ShrinathN/SimpleSpotWelder/README.md

# SimpleSpotWelder
I wanted a spot welder for 18650s so I designed this but then I didn't want a spot welder anymore so I never built it

This welder is designed to do
* Max 55J (more realistically 40J) solders
* Aprox 1000A for 100ms
