ShrinathN/SimpleSpotWelder/SimpleSpotWelderDesignLog.html

Simple Spot Welder Design Log

15 April 2025 - 1735 hours 2

FET Choice 2

17 April 2025 - 0000 hours 7

17 April 2025 - 2215 hours 7

18 April 2025 - 0152 hours 7

18 April 2025 - 1423 hours 8

19 April 2025 - 0413 hours 9

21 April 2025 - 1532 hours 10

3 May 2025 - 1550 hours 10

4 May 2025 - 0356 hours 10

# 15 April 2025 - 1735 hours

## FET Choice

Now is a good time to start the log. Not only to keep me focused but also so that I can itch my writing urge. Well let's get to into the meat then

I am debating if I should use IRF3205 (110A 50V 8mΩ NFETs) versus generic 50N03 (30A 50V 6.5mΩ FETs)

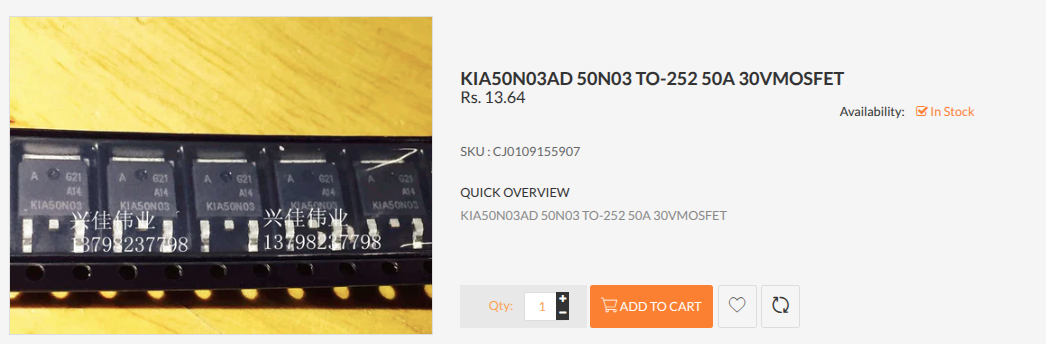
[picture p1: images/image10.png]


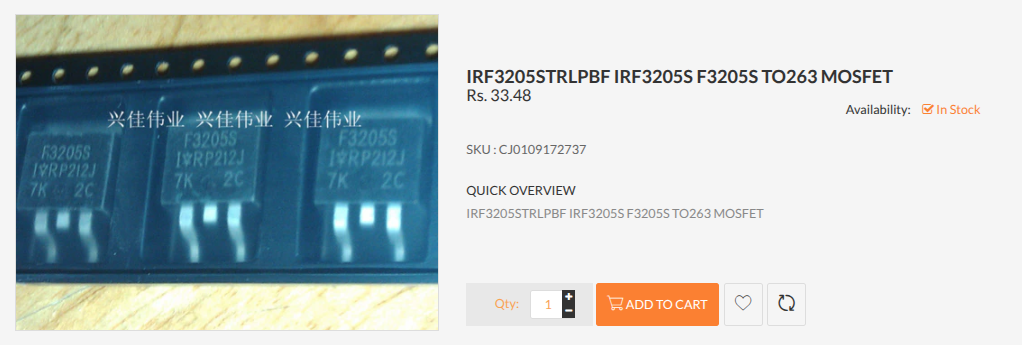
[picture p2: images/image4.png]


Ah the package of IRF3205 is TO-263 versus TO-252 for 50N03. Even though the price is more than double as much, IRF3205 seems like the better option because of the much larger footprint.

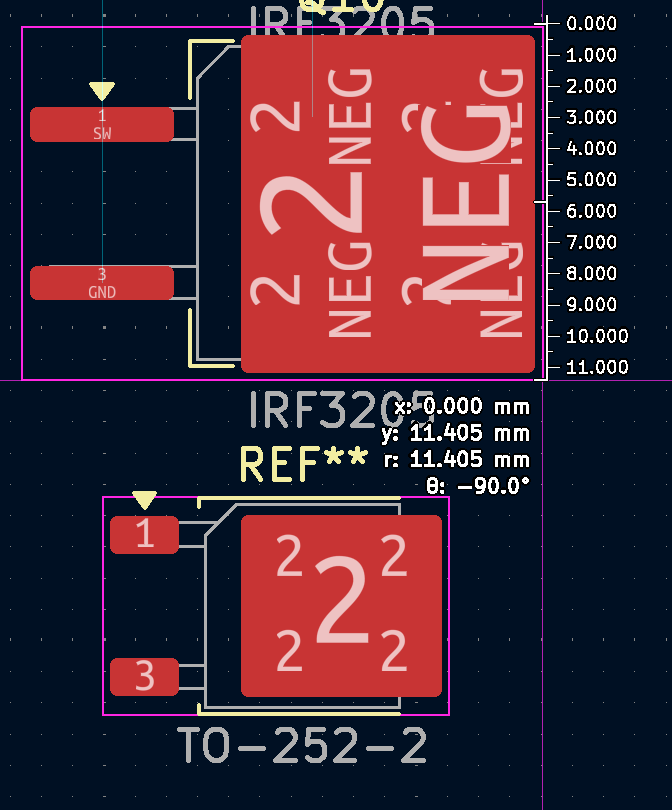
[picture p3: images/image6.png]


I choose IRF3205.

Tangent, writing this log has revealed to me that I may have been turning into an NPC, unable to focus on stuff and without an inner voice. I blame social media and distractions. Back to topic at hand.

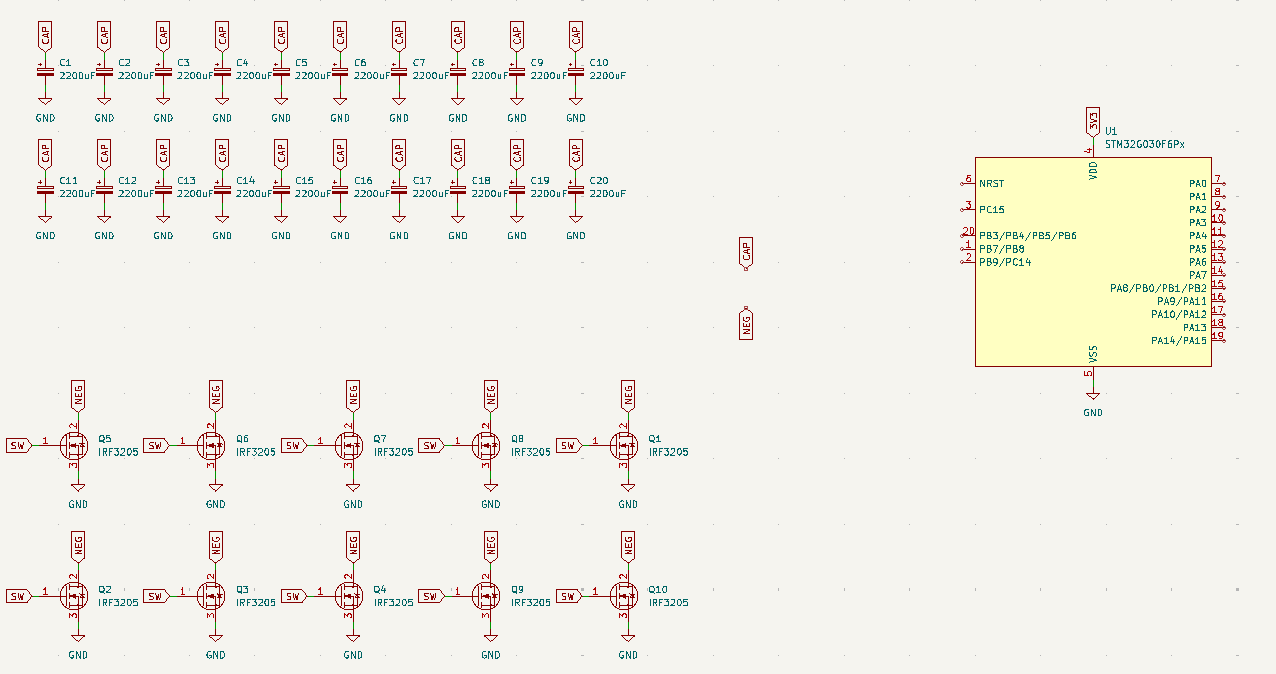
[picture p4: images/image2.png]
So this is how the schematics look right now. 

For making a decent spot welder, I need to have a decent pulse control. This means I should be able to turn on and off the MOSFETs very quickly, so that the linear region is as short as possible. This will also protect the MOSFETs.

The FETs have an Rds of 8mΩ, which 10 in parallel would mean 800uΩ.

At the normal 12V of the battery, it would equal to about 15000A of current. (V=IR)

Talking in charge, a 20x 2200uF capacitor bank, charged to 12V would have a total charge of 528mC (Q=CV).

Now if we take the charge, and the current, we get a discharge time of 35.2us (I=Q/t).

This means the entire capacitor bank would discharge in 35us if given a resistance of 800uΩ. Although this is just the theoretical max current, since the lead+trace+capacitor bank ESR resistance would dominate the calculation. I think I will have to assume a number for all of them because I cannot just assume it all to be 0.

The capacitor bank is 20x 2200uF 63V. So the total energy in the bank would be 55J, if charged to 50V. Since our FETs are 55V, it's better to limit charging to 45V, which would give us 44.45J. Now le

I am worried if the FETs will be able to tolerate the current peak.

I just found slightly better MOSFETs for the same price, but a lower voltage rating

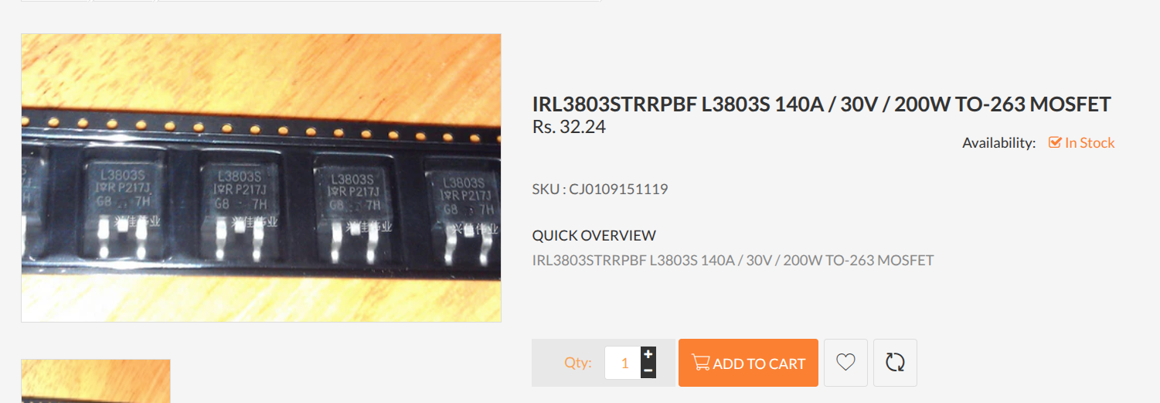
[picture p5: images/image5.png]


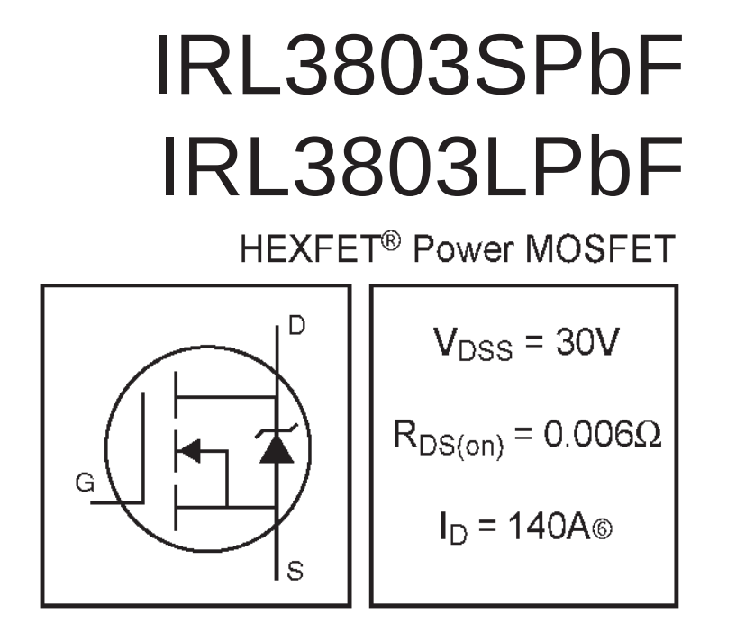
[picture p6: images/image11.png]


Rds is lower by 2mΩ. Not a large difference, but it will add up for sure.

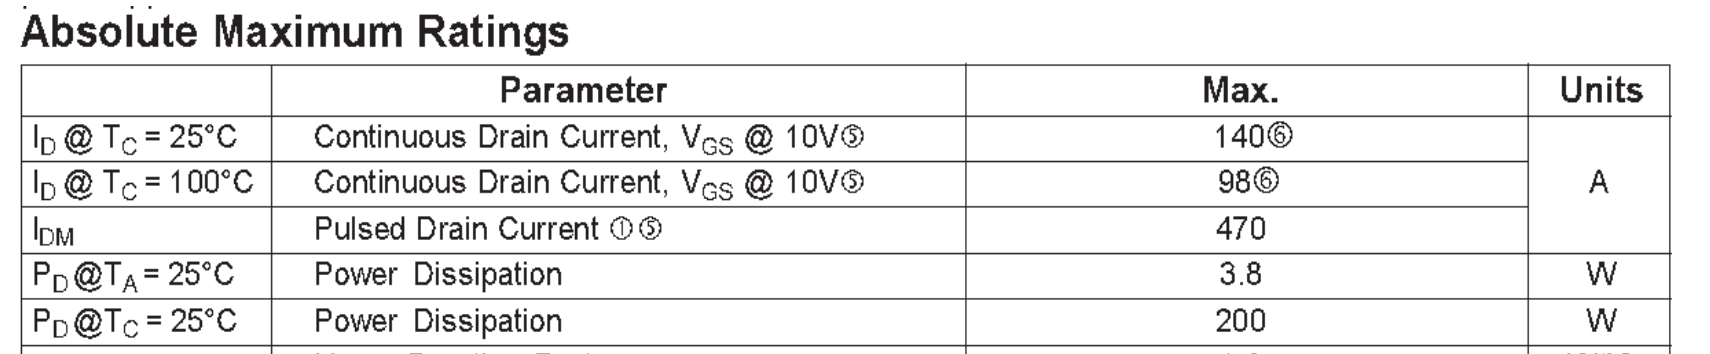
[picture p7: images/image8.png]


Pulse current is absolutely insane. 470A!!! Need to study datasheet more though

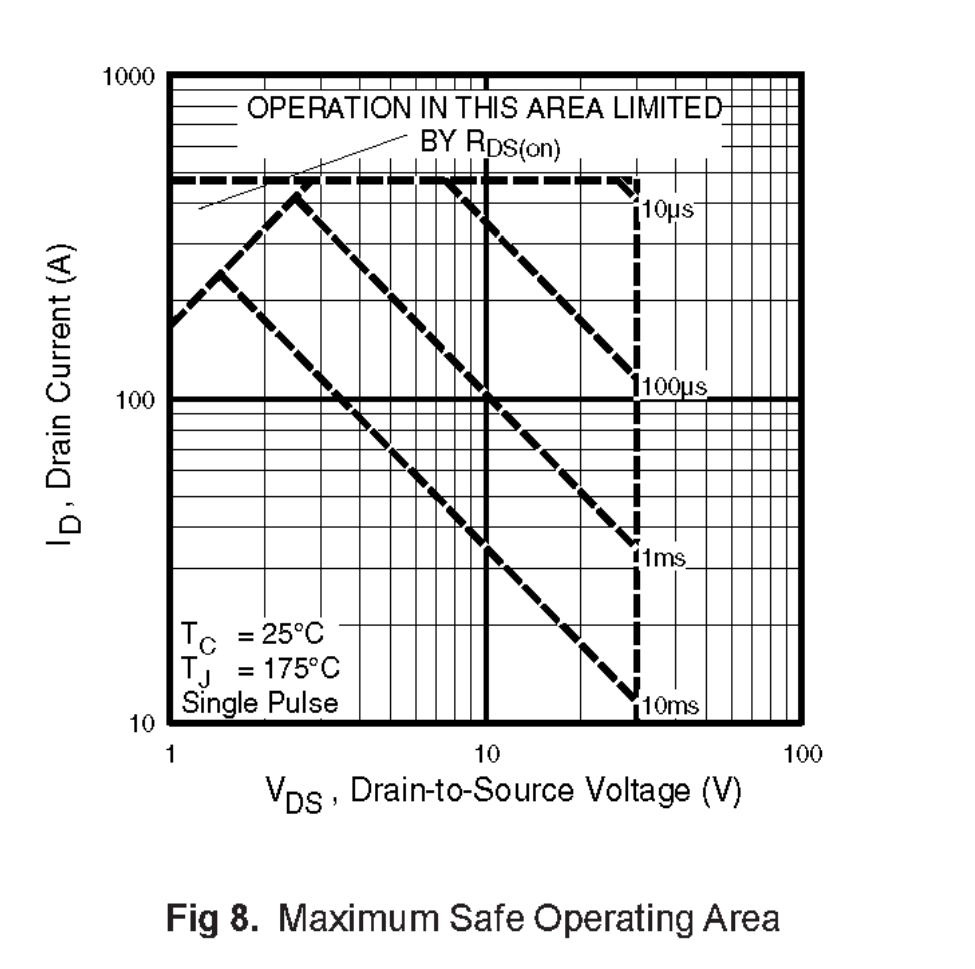
[picture p8: images/image13.png]


This image is awesome. I can do 100A @ 10V for 100us. Insane. But at 12V, not even 10ms at a lot lower current. Anyway, this means I can do 400A at 11V or 12V as long as the pulse is incredibly short at 10us. It is a good thing I am planning on having even shorter pulses at 1us.

So next step, checking if that kind of pulse timing is actually possible.

# 17 April 2025 - 0000 hours

So continuing from where I left. I was studying the new MOSFET datasheet. During the day I read a few things and talked to ChatGPT and I saw an interesting field.



The avalanche energy is the interesting bit. This means I can actually turn the instantaneous power dissipation (i.e. in watts) into joules (by multiplying with the time) and compare it directly with the above number, since my application is a pulse of energy, not repetitive pulses.

So now I will have to calculate how fast I can actually turn on the MOSFETs.

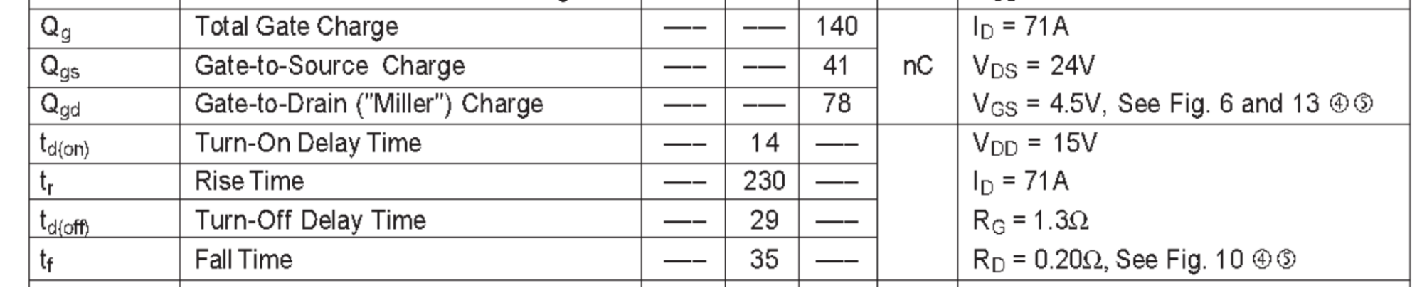
[picture p9: images/image7.png]


The above image gives us everything we need.

# 17 April 2025 - 2215 hours

New idea, lets use small SOT-23 FETs to do the actual gate driving for the MOSFET array.

# 18 April 2025 - 0152 hours

I will use the cheap CJ3400 and CJ3401 FETs that I have.

# 18 April 2025 - 1423 hours

This is a log of events last night.

I created the input stage of the circuit. It can accept a voltage of up to 30V (although 12V is what its nominally made for)

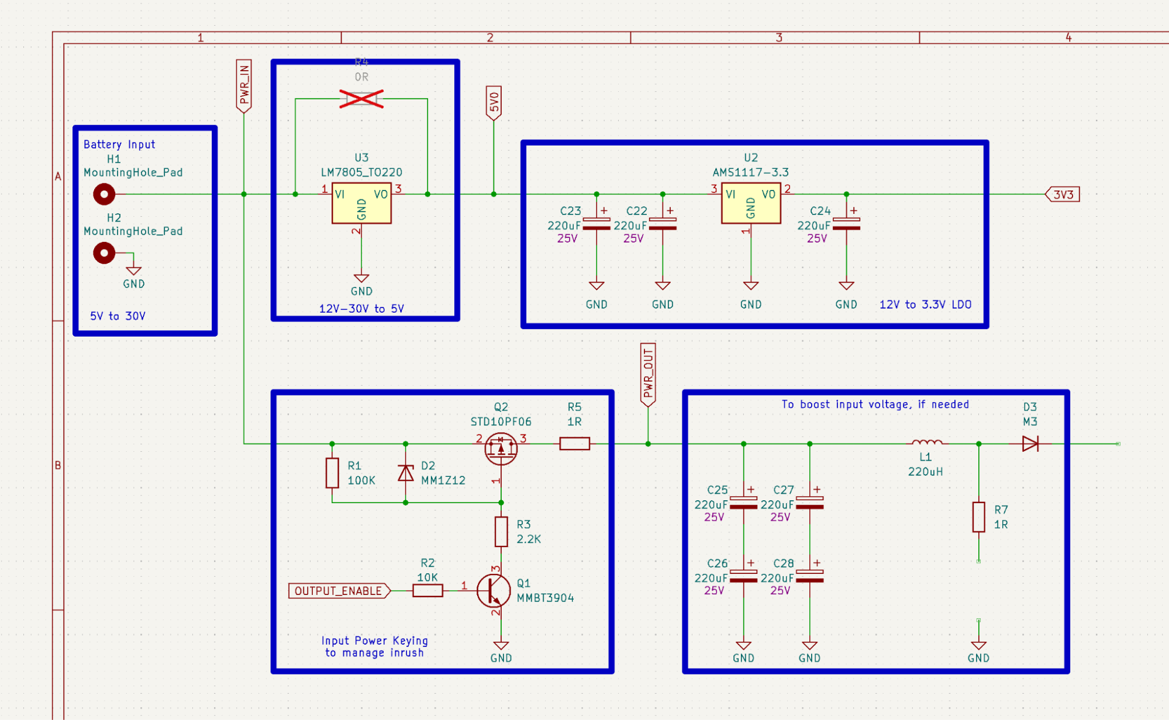
[picture p10: images/image9.png]


I added an LM7805 to step down 12V to 30V to 5V which is stepped down to 3.3V for the MCU by AMS1117-3.3. On the bottom power path we have the STD10PF06 PMOS to switch power on and off to the capacitor bank, with a 1R inrush limiting resistor. This part is going to be pulsed anyway, to ensure inrush current isn’t a problem. I could also include a dedicated precharge path. I’ll add that.

Then we have the boost stage which can optionally boost the input voltage as high as required. Up to 25V (for now, this is limited by the capacitor bank voltage and the main switching FETs Vgs max voltage). I am trying to decide on a decent FET for the boost stage as well which can handle a high voltage (50V+).

FINALLY!!! After a lot of distraction I finally decided on the generic 50N03 NFETs. 50V, 30A, pretty good I would say, in a TO-252 package.

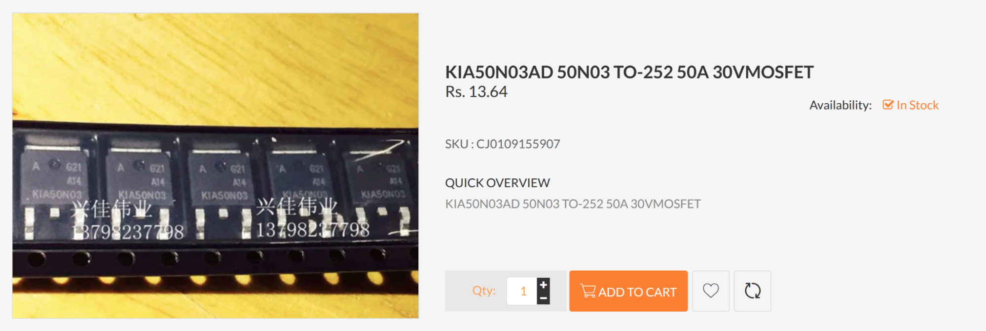
[picture p11: images/image12.png]


Also I think it would be a good idea to make voltage and current ratings visible in schematics, at least for the power electronics part of the circuit. I should make this a standard part of the design process from now on.

I got the voltage wrong. The FET is 30V and 50A, not the other way around. The search continues…

# 19 April 2025 - 0413 hours

Well that’s not really a problem either way, 30V FETs will do just fine!

Also I figured out how to drive the FETs, with smaller FETs which will be driven like this.

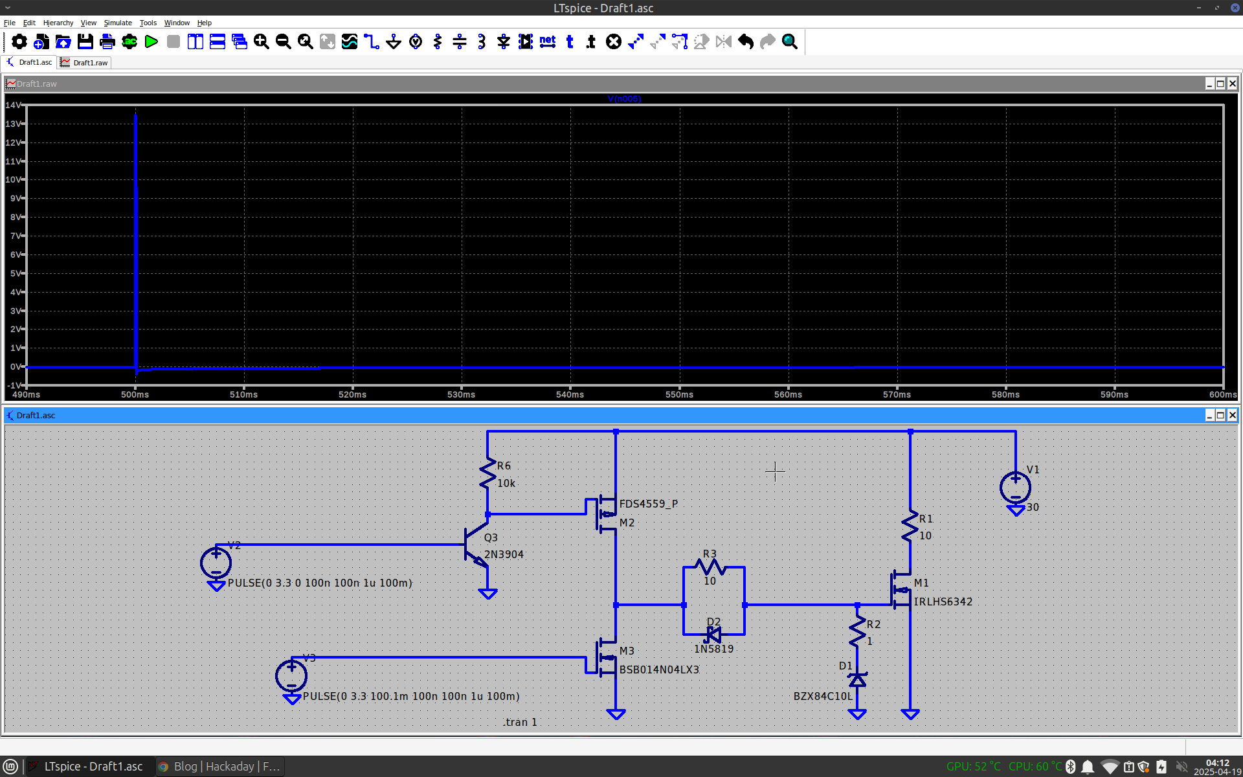
[picture p12: images/image1.png]


TODO: should probably search if motor drivers or anything like that can work here. Buffers?

# 21 April 2025 - 1532 hours

I have updated the schematics. Everything is mostly done, schematics wise. Just need to do some math to figure out if I’ll blow this up as soon as I turn it on or what

# 3 May 2025 - 1550 hours

Hello. I still have been working on this but didn’t bother to update the document. Not too many changes though.

Alright, now let's try to calculate the temperature rise properly.

# 4 May 2025 - 0356 hours

- Added a 12V LDO regulator to drive the FETs using when PWR_IN > 12V
