ShrinathN/SimpleSpotWelder/SimpleSpotWelder-MCU Section.pdf

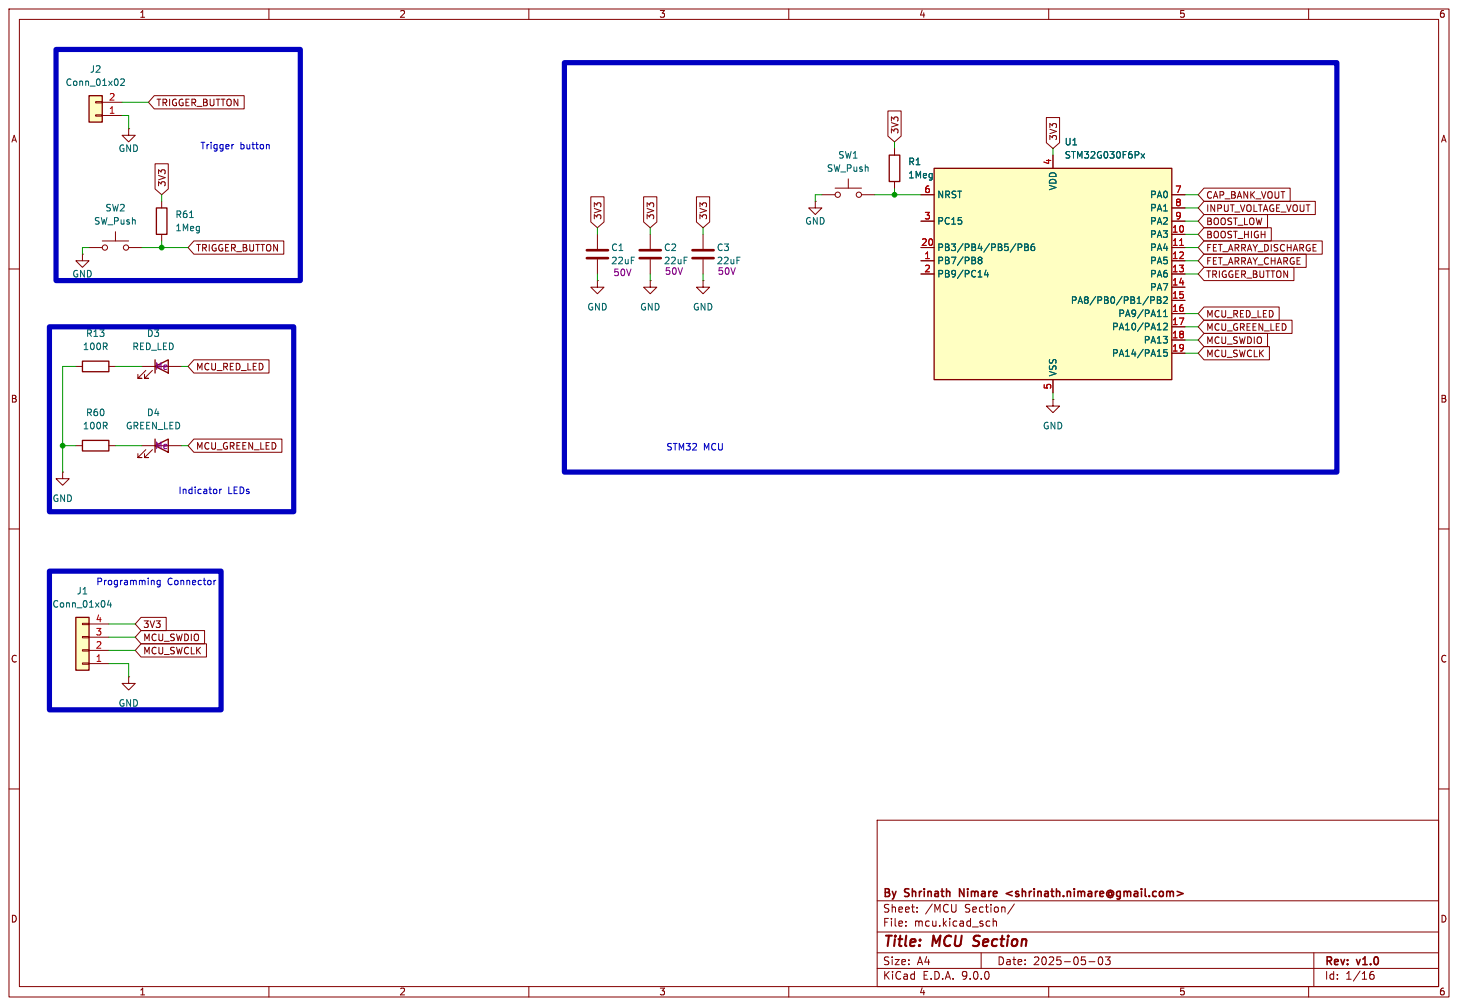
[picture p13: page 1]

Id: 1/16 Title: MCU Section

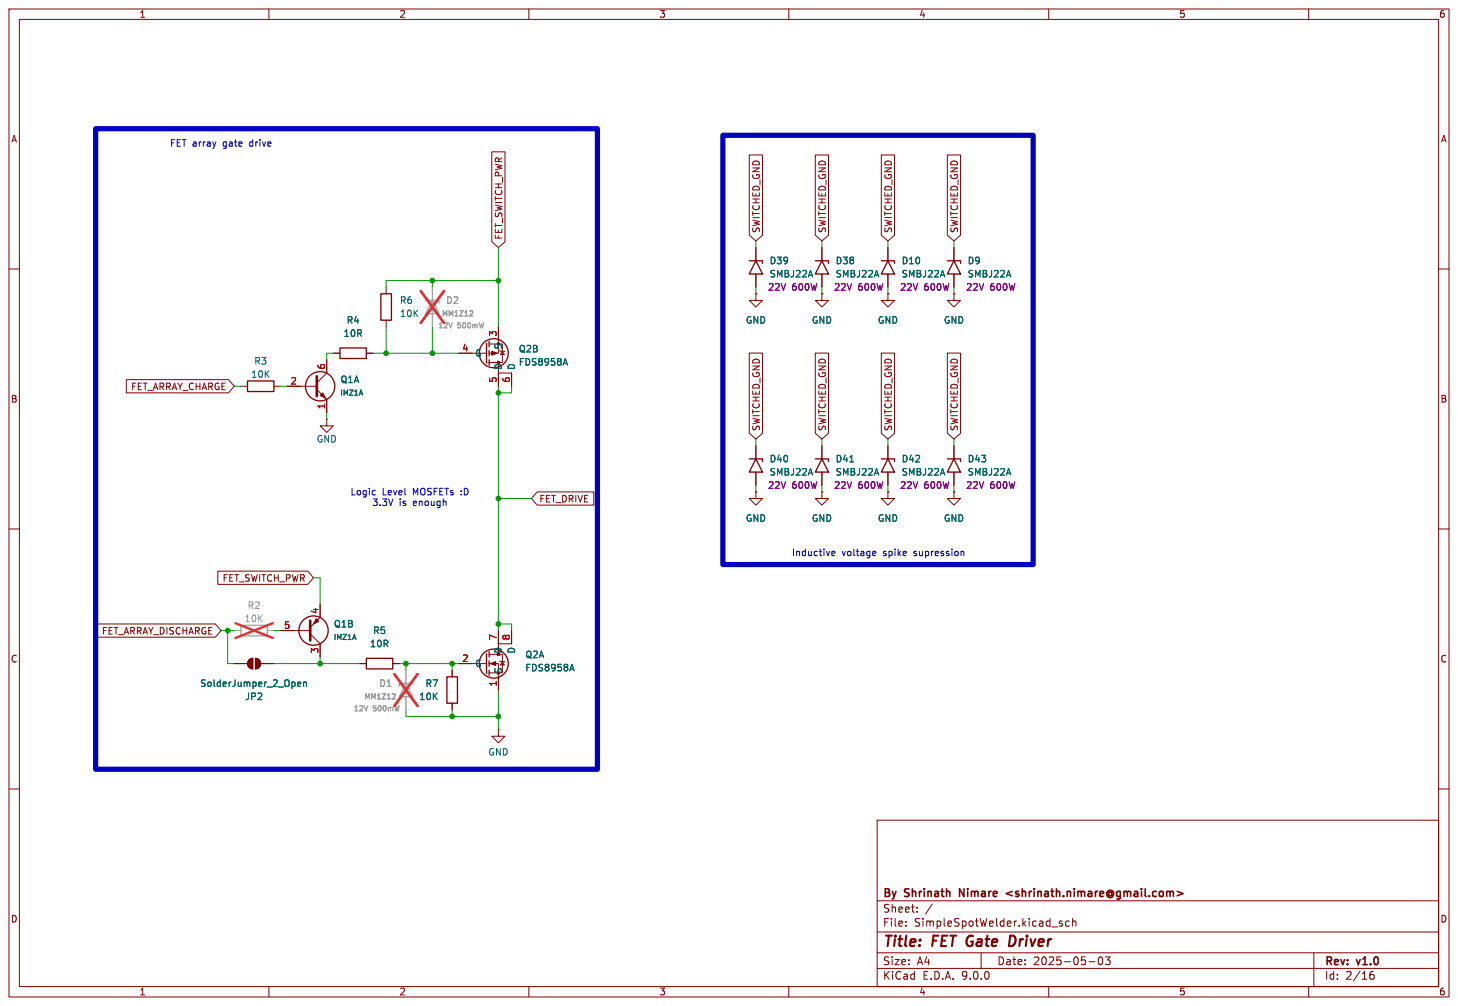
[picture p14: page 2]

FET array gate drive

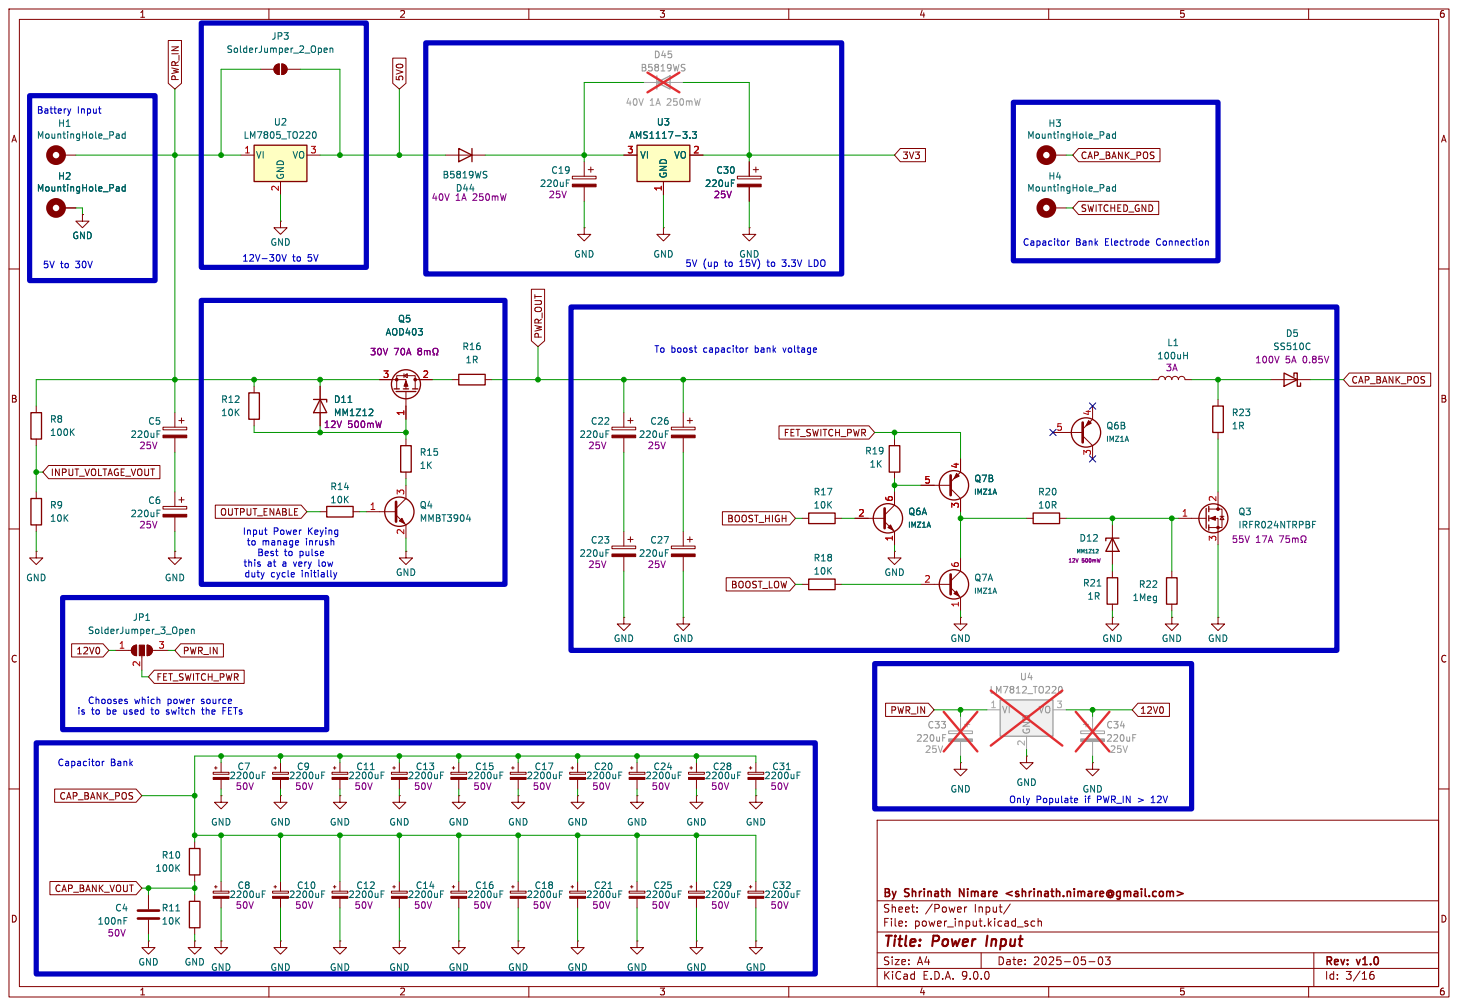
[picture p15: page 3]

Input Power Keying
to manage inrush Best to pulse

this at a very low

duty cycle initially Chooses which power source

is to be used to switch the FETs

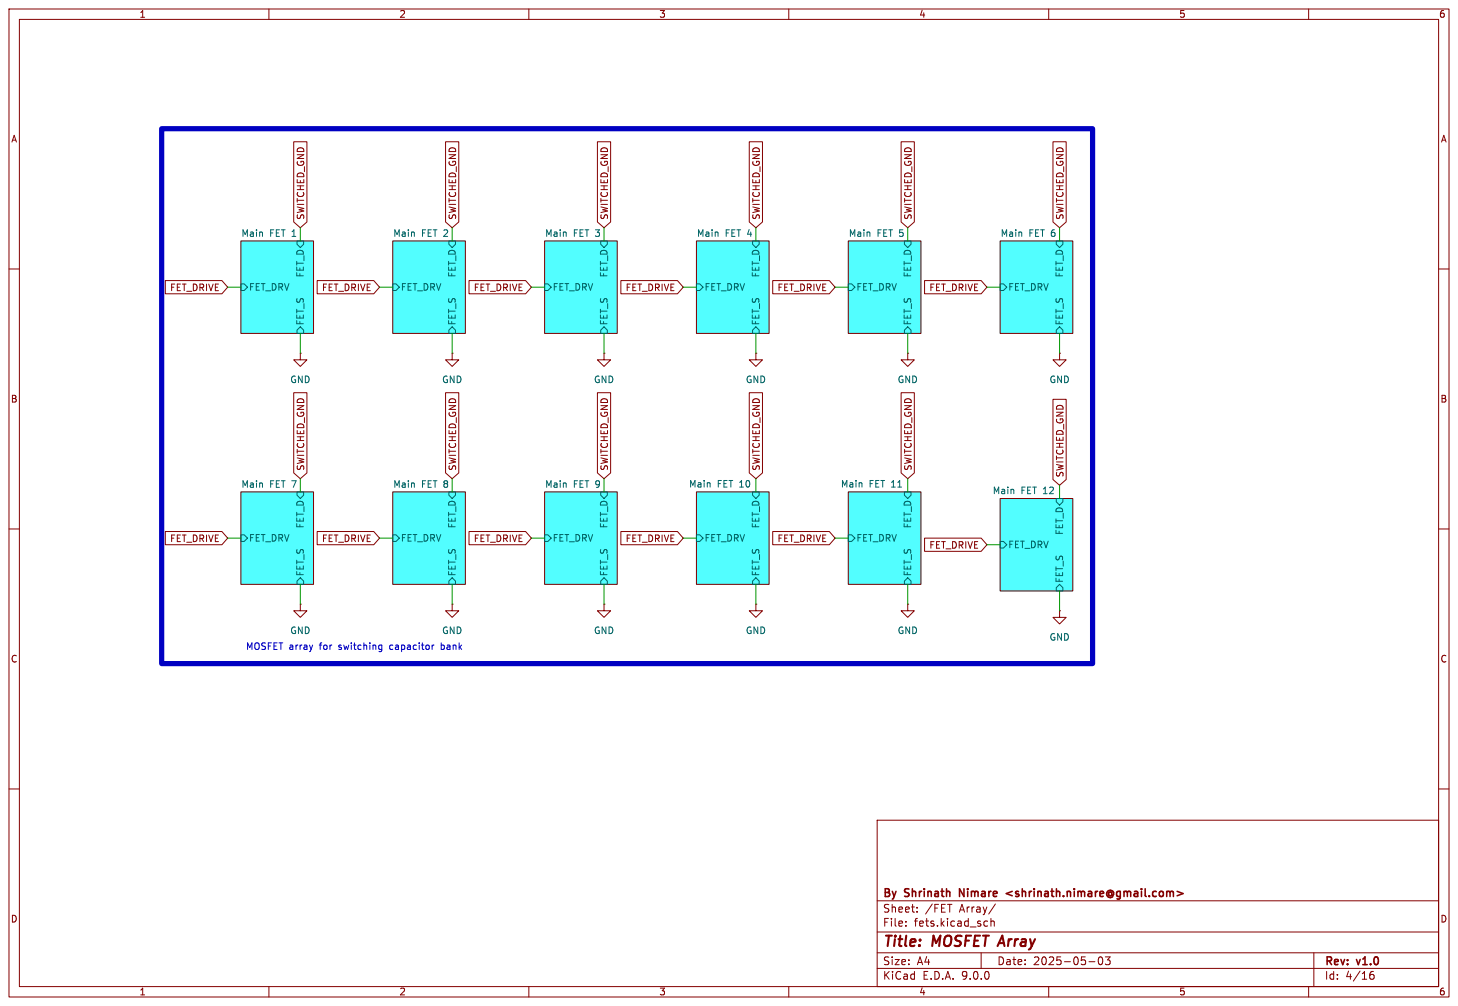
[picture p16: page 4]

Id: 4/16 Title: MOSFET Array

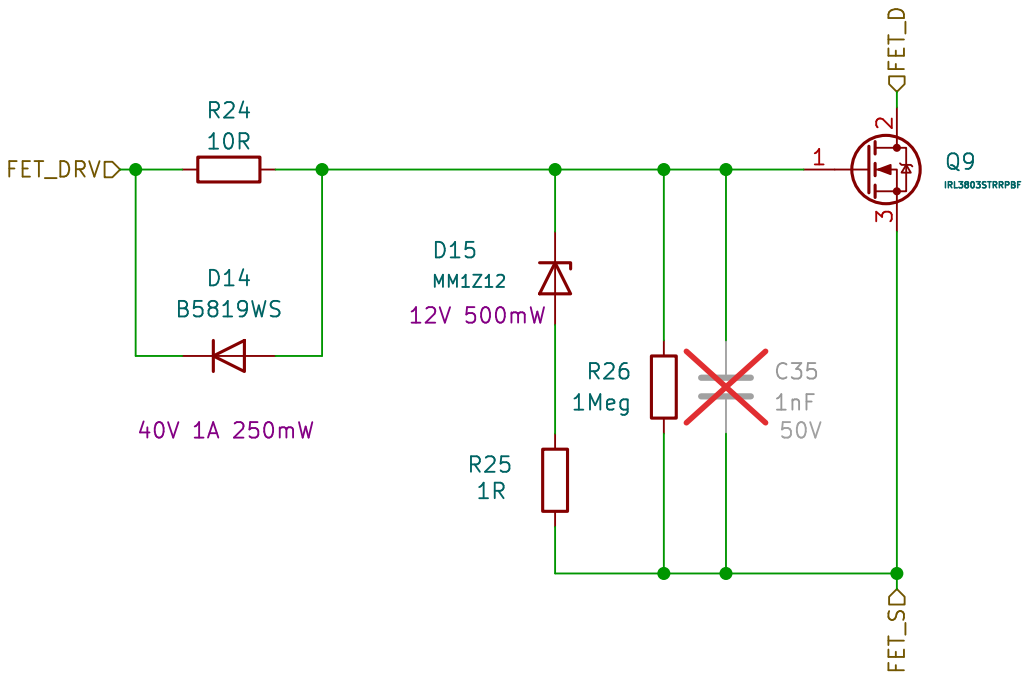
[picture p17: page 5]

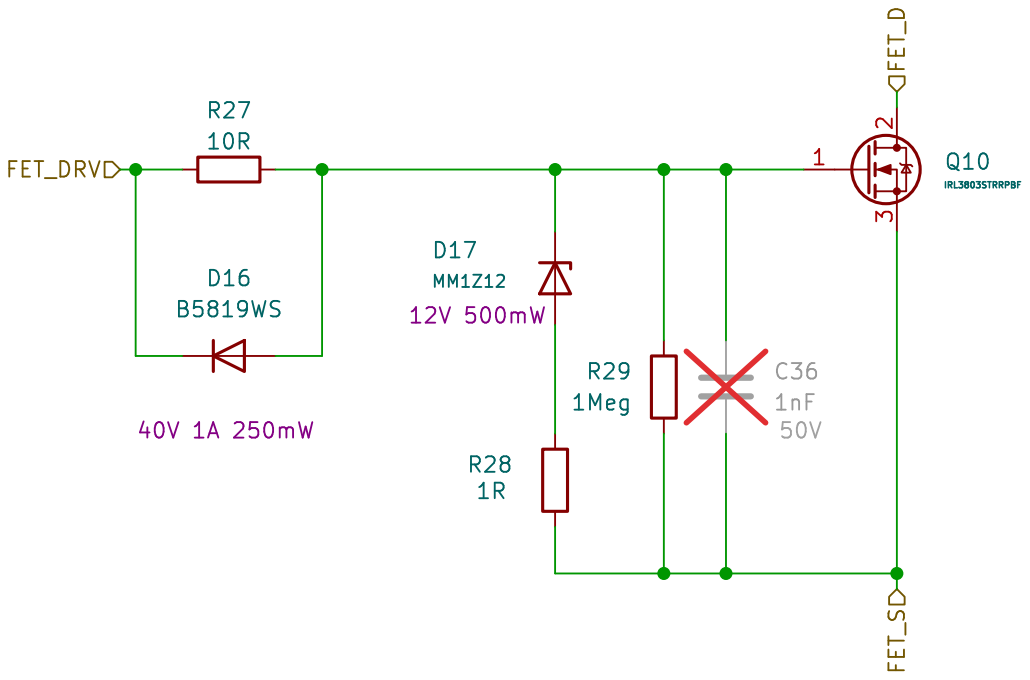
[picture p18: page 6]

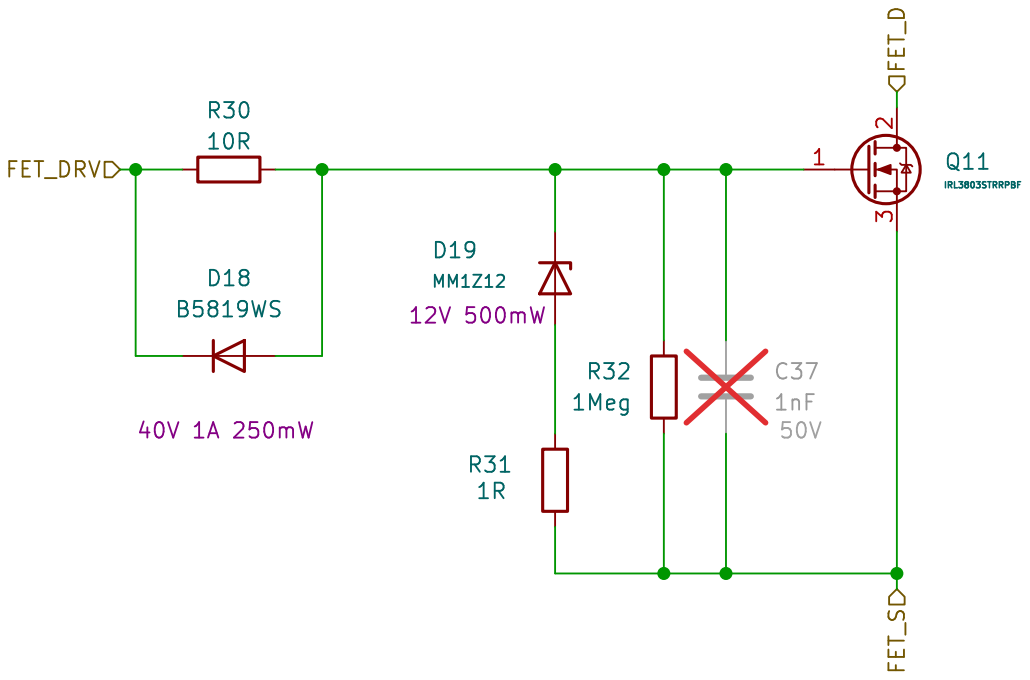
[picture p19: page 7]

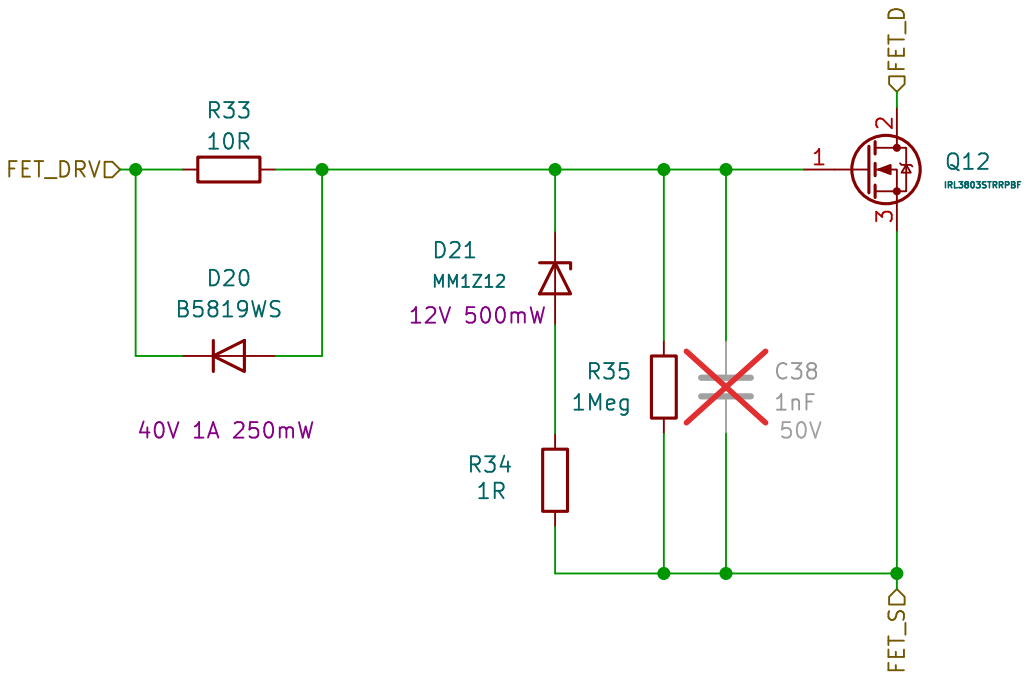
[picture p20: page 8]

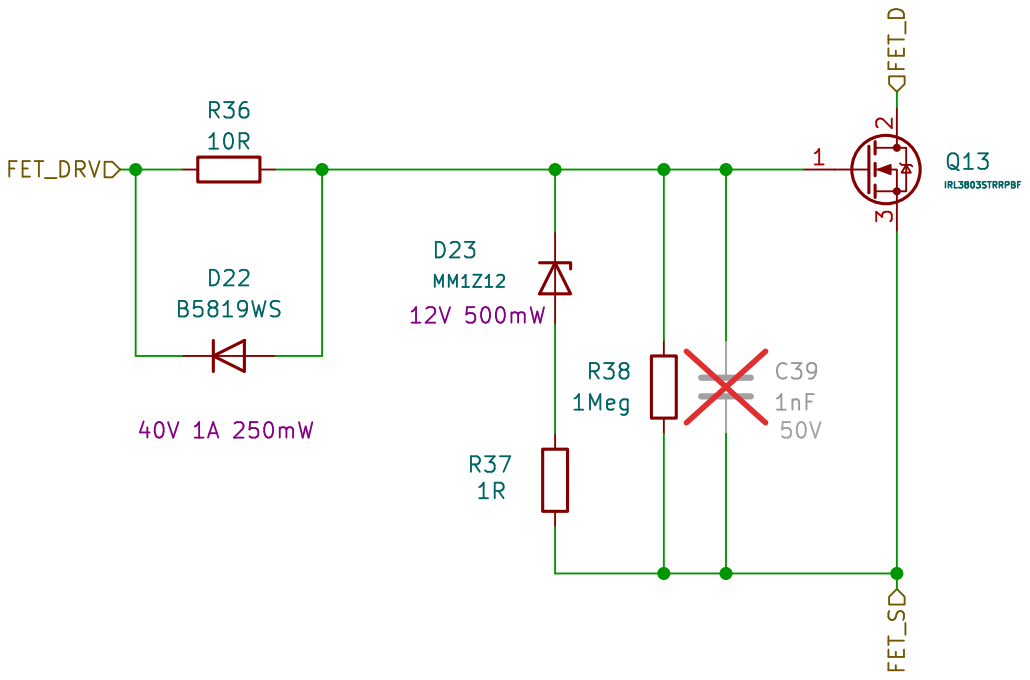
[picture p21: page 9]

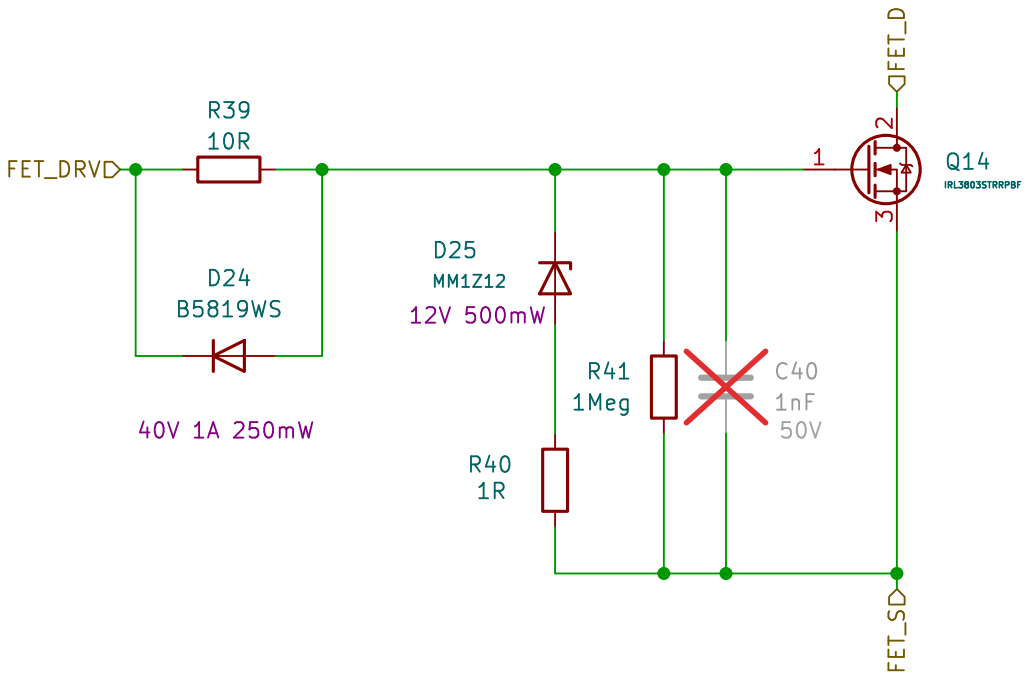
[picture p22: page 10]

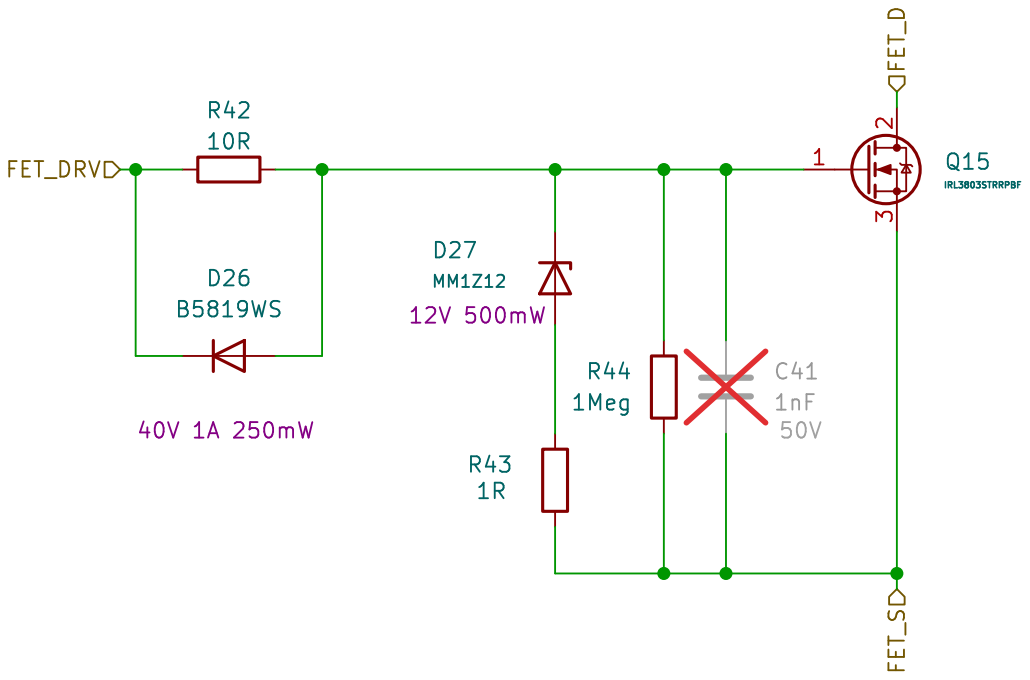
[picture p23: page 11]

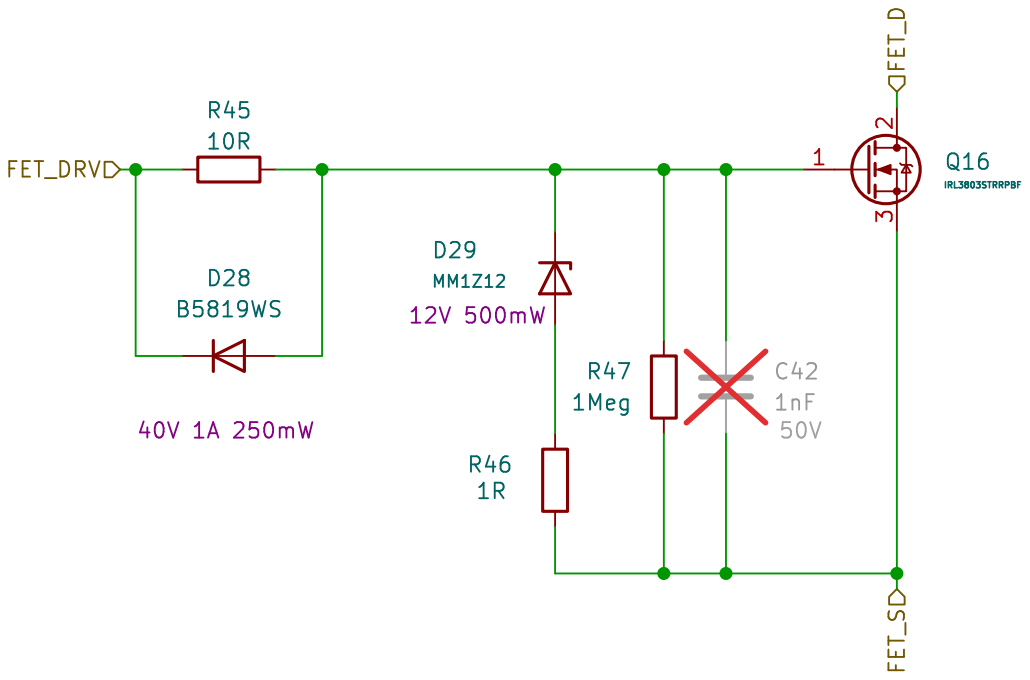
[picture p24: page 12]

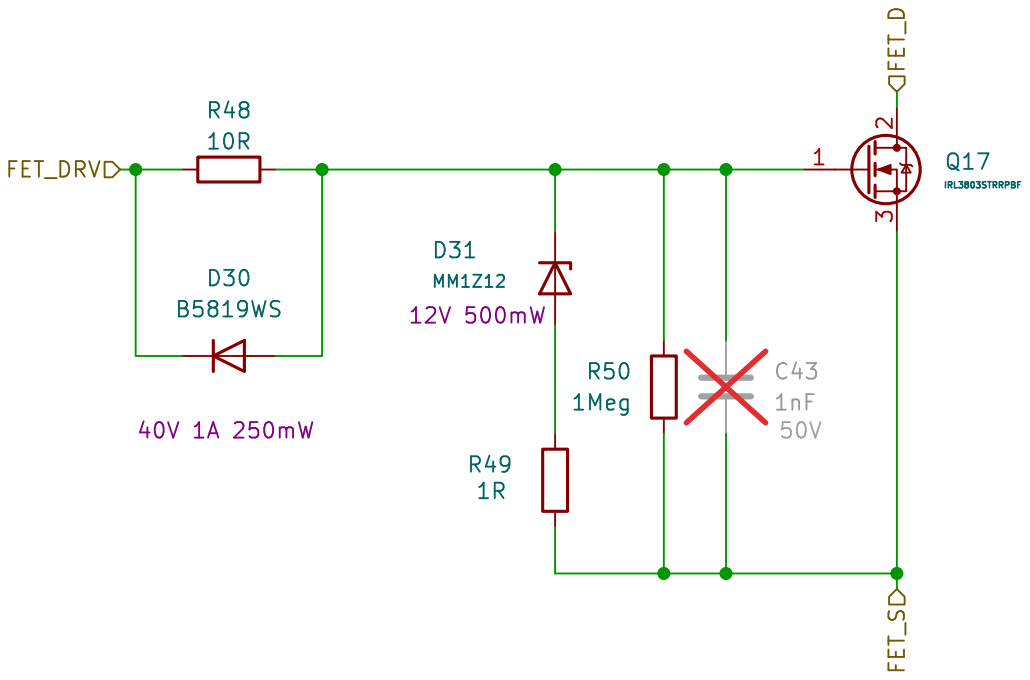
[picture p25: page 13]

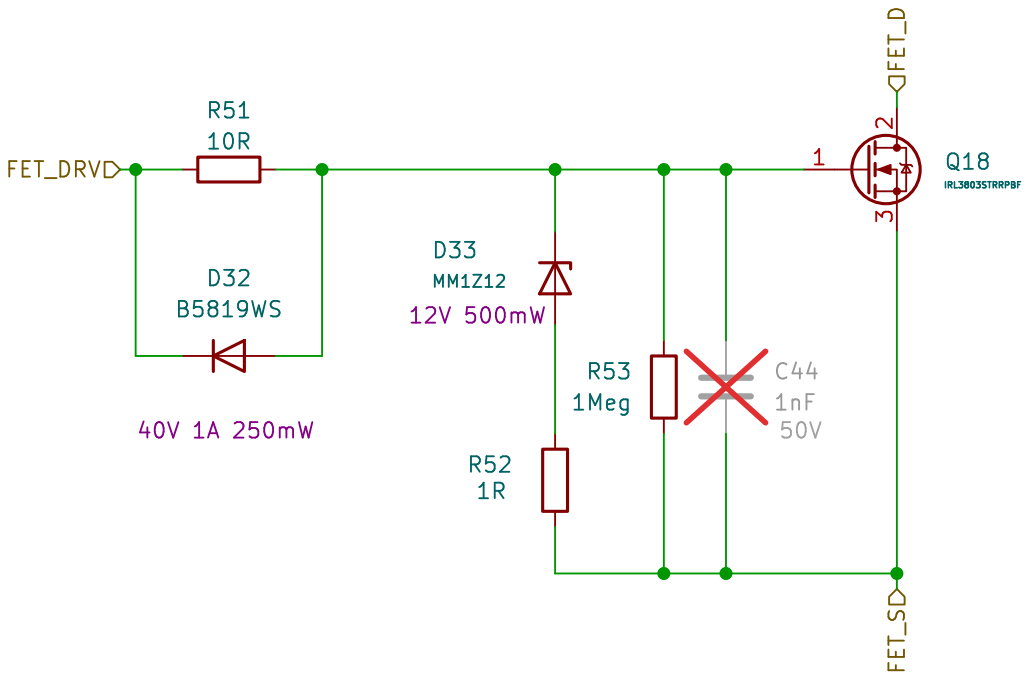
[picture p26: page 14]

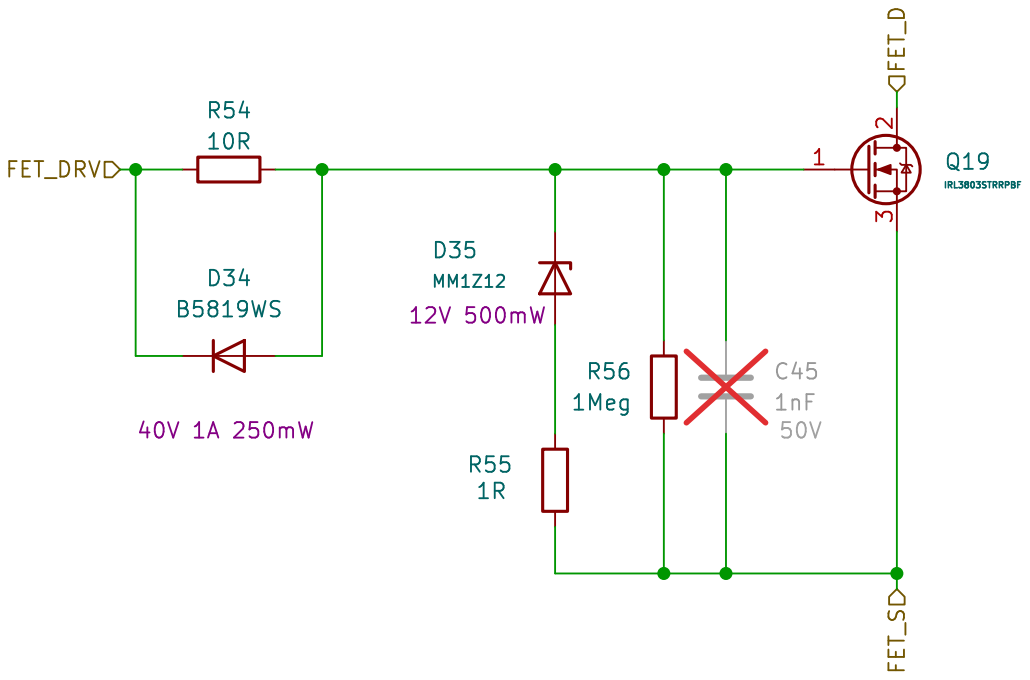
[picture p27: page 15]

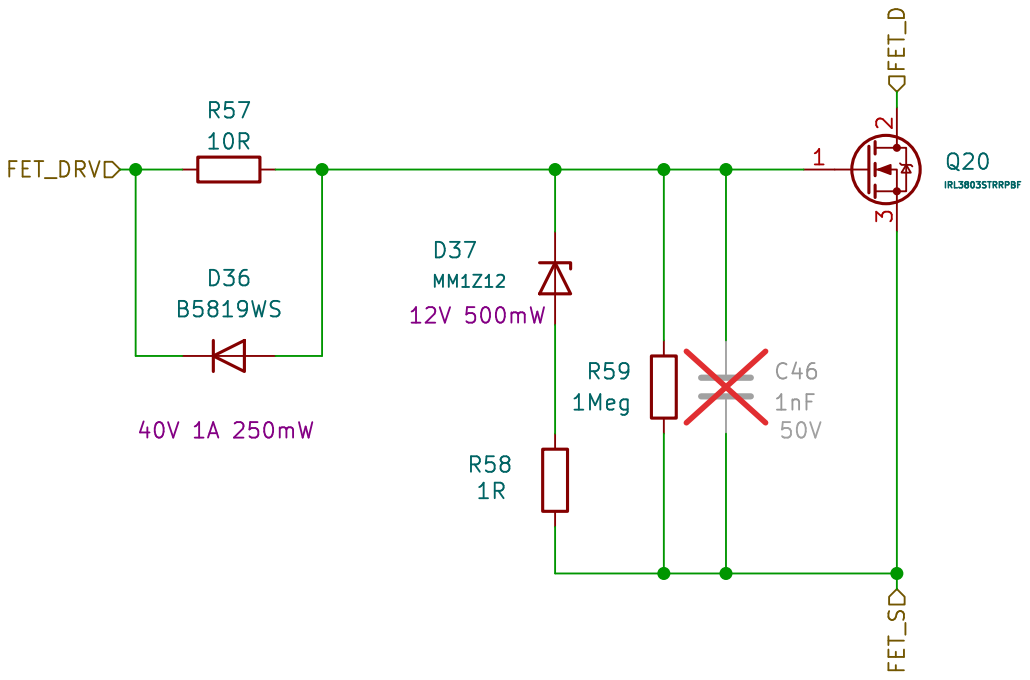
[picture p28: page 16]
