ShrinathN/SimpleSpotWelder/SimpleSpotWelder.kicad_pcb

## KiCad design SimpleSpotWelder.kicad_pcb (2025-05-04)

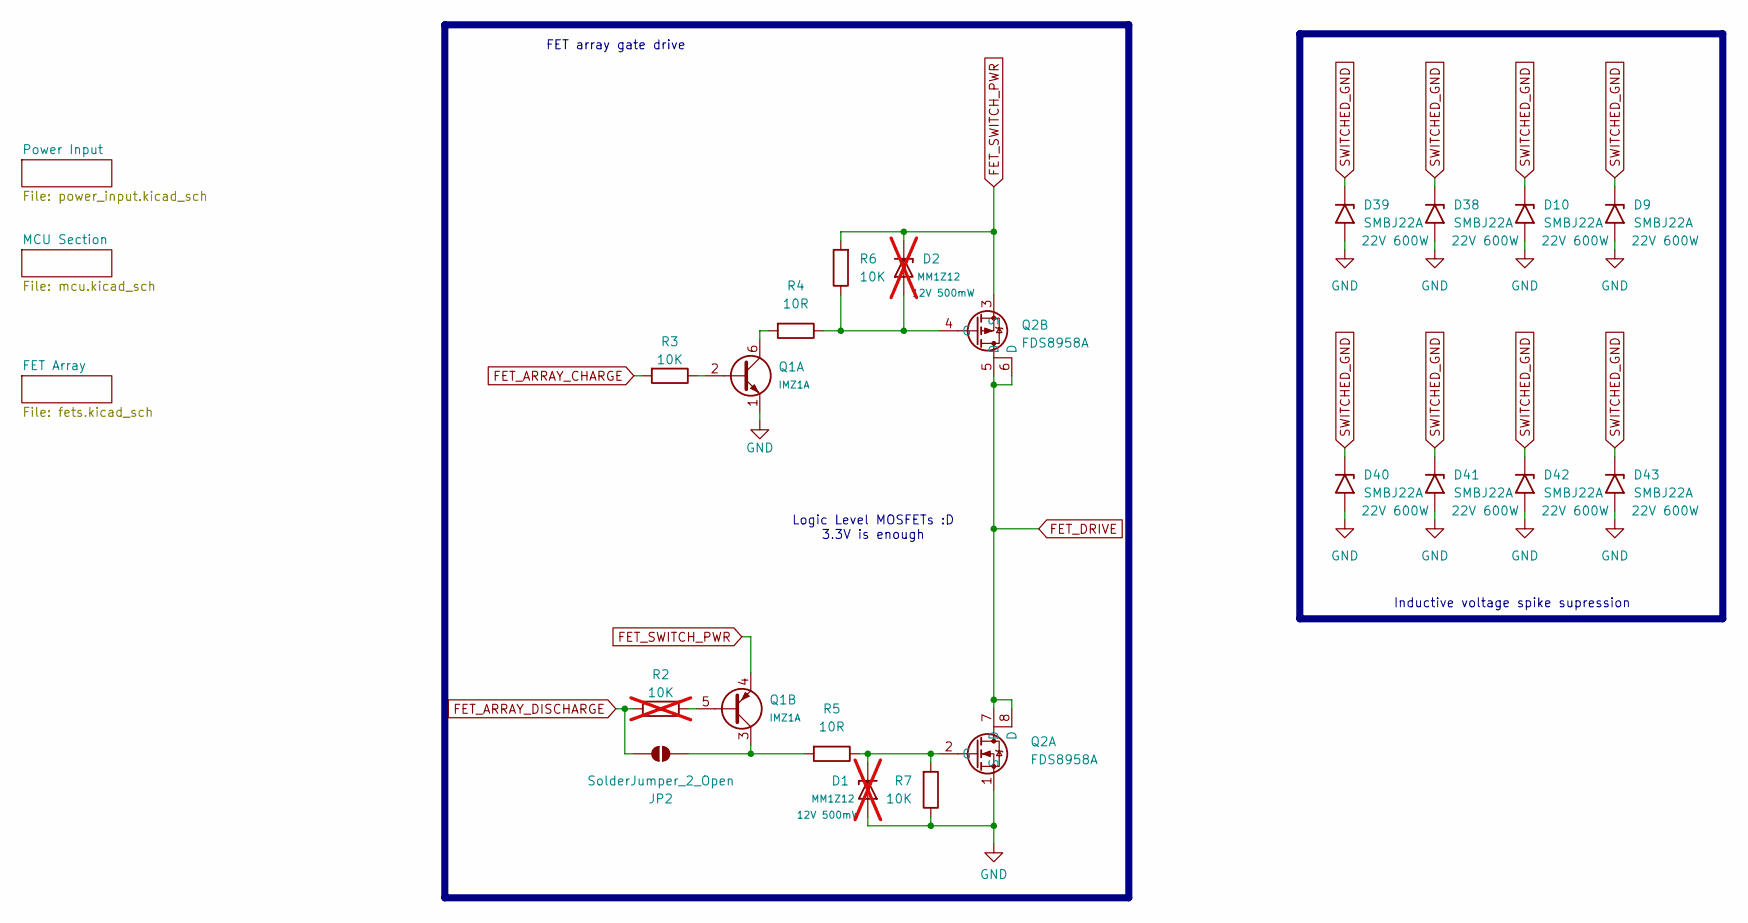
[picture p29: schematic SimpleSpotWelder.kicad_sch, FET Gate Driver]

Parts:
D1, D2: MM1Z12; D_SOD-123; Rating 12V 500mW; not fitted
D9, D10, D38, D39, D40, D41, D42, D43: SMBJ22A; D_SMB; Rating 22V 600W
JP2: SolderJumper_2_Open; SolderJumper-2_P1.3mm_Open_Pad1.0x1.5mm
Q1: IMZ1A; SOT-23-6
Q2: FDS8958A; SO-8_3.9x4.9mm_P1.27mm
R2: 10K; R_0805_2012Metric; not fitted
R3, R6, R7: 10K; R_0805_2012Metric
R4, R5: 10R; R_0805_2012Metric

Connections:
FET_ARRAY_CHARGE: R3.2; also elsewhere on the board
FET_ARRAY_DISCHARGE: JP2.2 (B), R2.2; also elsewhere on the board
FET_DRIVE: Q2.5 (D), Q2.6 (D), Q2.7 (D), Q2.8 (D); also elsewhere on the board
FET_SWITCH_PWR: D2.1 (K), Q1.4 (E2), Q2.3 (S), R6.2; also elsewhere on the board
GND: D1.2 (A), D9.2 (A2), D10.2 (A2), D38.2 (A2), D39.2 (A2), D40.2 (A2), D41.2 (A2), D42.2 (A2), D43.2 (A2), Q1.1 (E1), Q2.1 (S), R7.1; also elsewhere on the board
unnamed: D1.1 (K), Q2.2 (G), R5.1, R7.2
unnamed: D2.2 (A), Q2.4 (G), R4.1, R6.1
unnamed: JP2.1 (A), Q1.3 (C2), R5.2
unnamed: Q1.2 (B1), R3.1
unnamed: Q1.6 (C1), R4.2
unnamed: Q1.5 (B2), R2.1
SWITCHED_GND: D9.1 (A1), D10.1 (A1), D38.1 (A1), D39.1 (A1), D40.1 (A1), D41.1 (A1), D42.1 (A1), D43.1 (A1); also elsewhere on the board

Notes on the sheet:
Logic Level MOSFETs :D 3.3V is enough
Inductive voltage spike supression
FET array gate drive

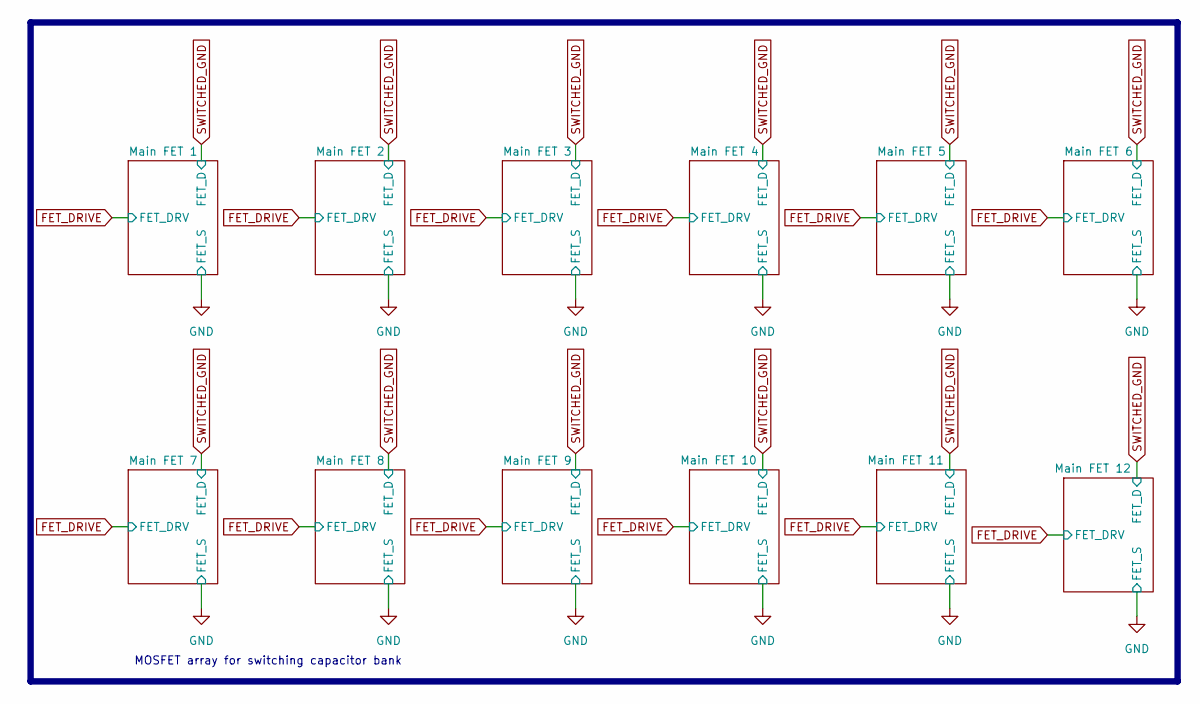
[picture p30: schematic fets.kicad_sch, MOSFET Array]

Notes on the sheet:
MOSFET array for switching capacitor bank

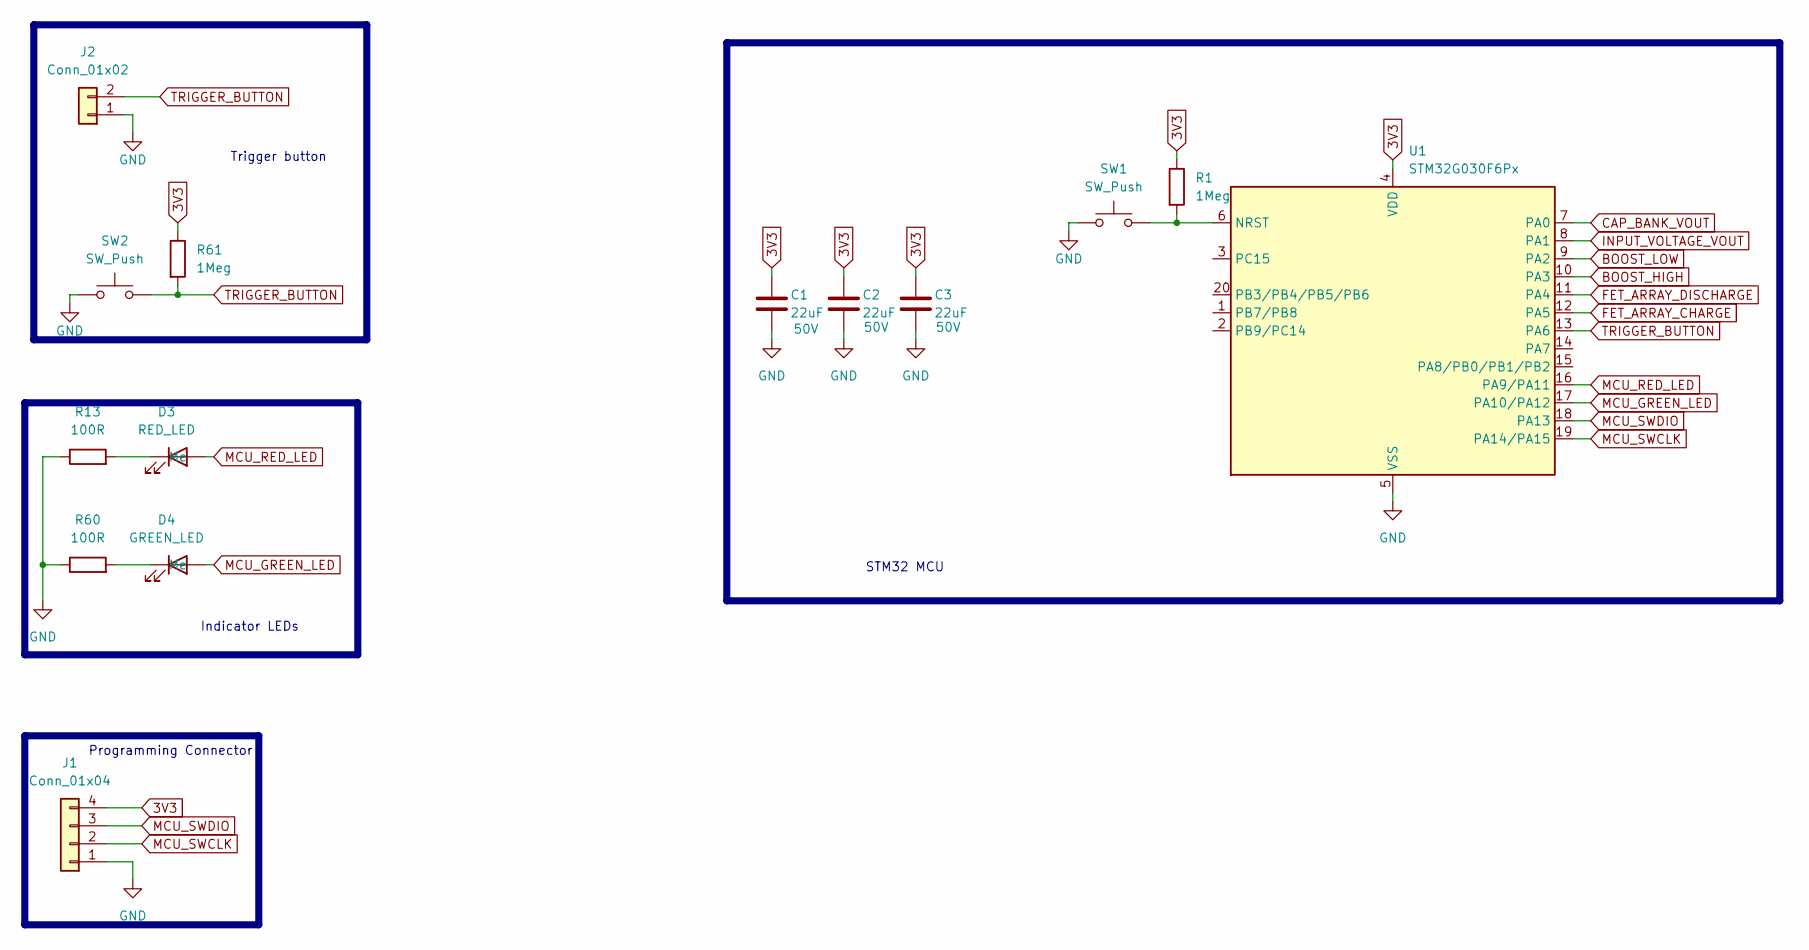
[picture p31: schematic mcu.kicad_sch, MCU Section]

Parts:
C1, C2, C3: 22uF; C_0805_2012Metric; Rating 50V
D3: RED_LED; LED_0805_2012Metric
D4: GREEN_LED; LED_0805_2012Metric
J1: Conn_01x04; PinSocket_1x04_P2.54mm_Vertical
J2: Conn_01x02; PinSocket_1x02_P2.54mm_Vertical
R1, R61: 1Meg; R_0805_2012Metric
R13, R60: 100R; R_0805_2012Metric
SW1, SW2: SW_Push; SW_Push_1P1T_XKB_TS-1187A
U1: STM32G030F6Px; TSSOP-20_4.4x6.5mm_P0.65mm

Connections:
3V3: C1.1, C2.1, C3.1, J1.4, R1.1, R61.1, U1.4 (VDD); also elsewhere on the board
BOOST_HIGH: U1.10 (PA3); also elsewhere on the board
BOOST_LOW: U1.9 (PA2); also elsewhere on the board
CAP_BANK_VOUT: U1.7 (PA0); also elsewhere on the board
FET_ARRAY_CHARGE: U1.12 (PA5); also elsewhere on the board
FET_ARRAY_DISCHARGE: U1.11 (PA4); also elsewhere on the board
GND: C1.2, C2.2, C3.2, J1.1, J2.1, R13.1, R60.1, SW1.1, SW2.1, U1.5 (VSS); also elsewhere on the board
INPUT_VOLTAGE_VOUT: U1.8 (PA1); also elsewhere on the board
MCU_GREEN_LED: D4.2 (A), U1.17 (PA10/PA12)
MCU_RED_LED: D3.2 (A), U1.16 (PA9/PA11)
MCU_SWCLK: J1.2, U1.19 (PA14/PA15)
MCU_SWDIO: J1.3, U1.18 (PA13)
unnamed: D3.1 (K), R13.2
unnamed: D4.1 (K), R60.2
unnamed: R1.2, SW1.2, U1.6 (NRST)
TRIGGER_BUTTON: J2.2, R61.2, SW2.2, U1.13 (PA6)

Notes on the sheet:
STM32 MCU
Indicator LEDs
Programming Connector
Trigger button

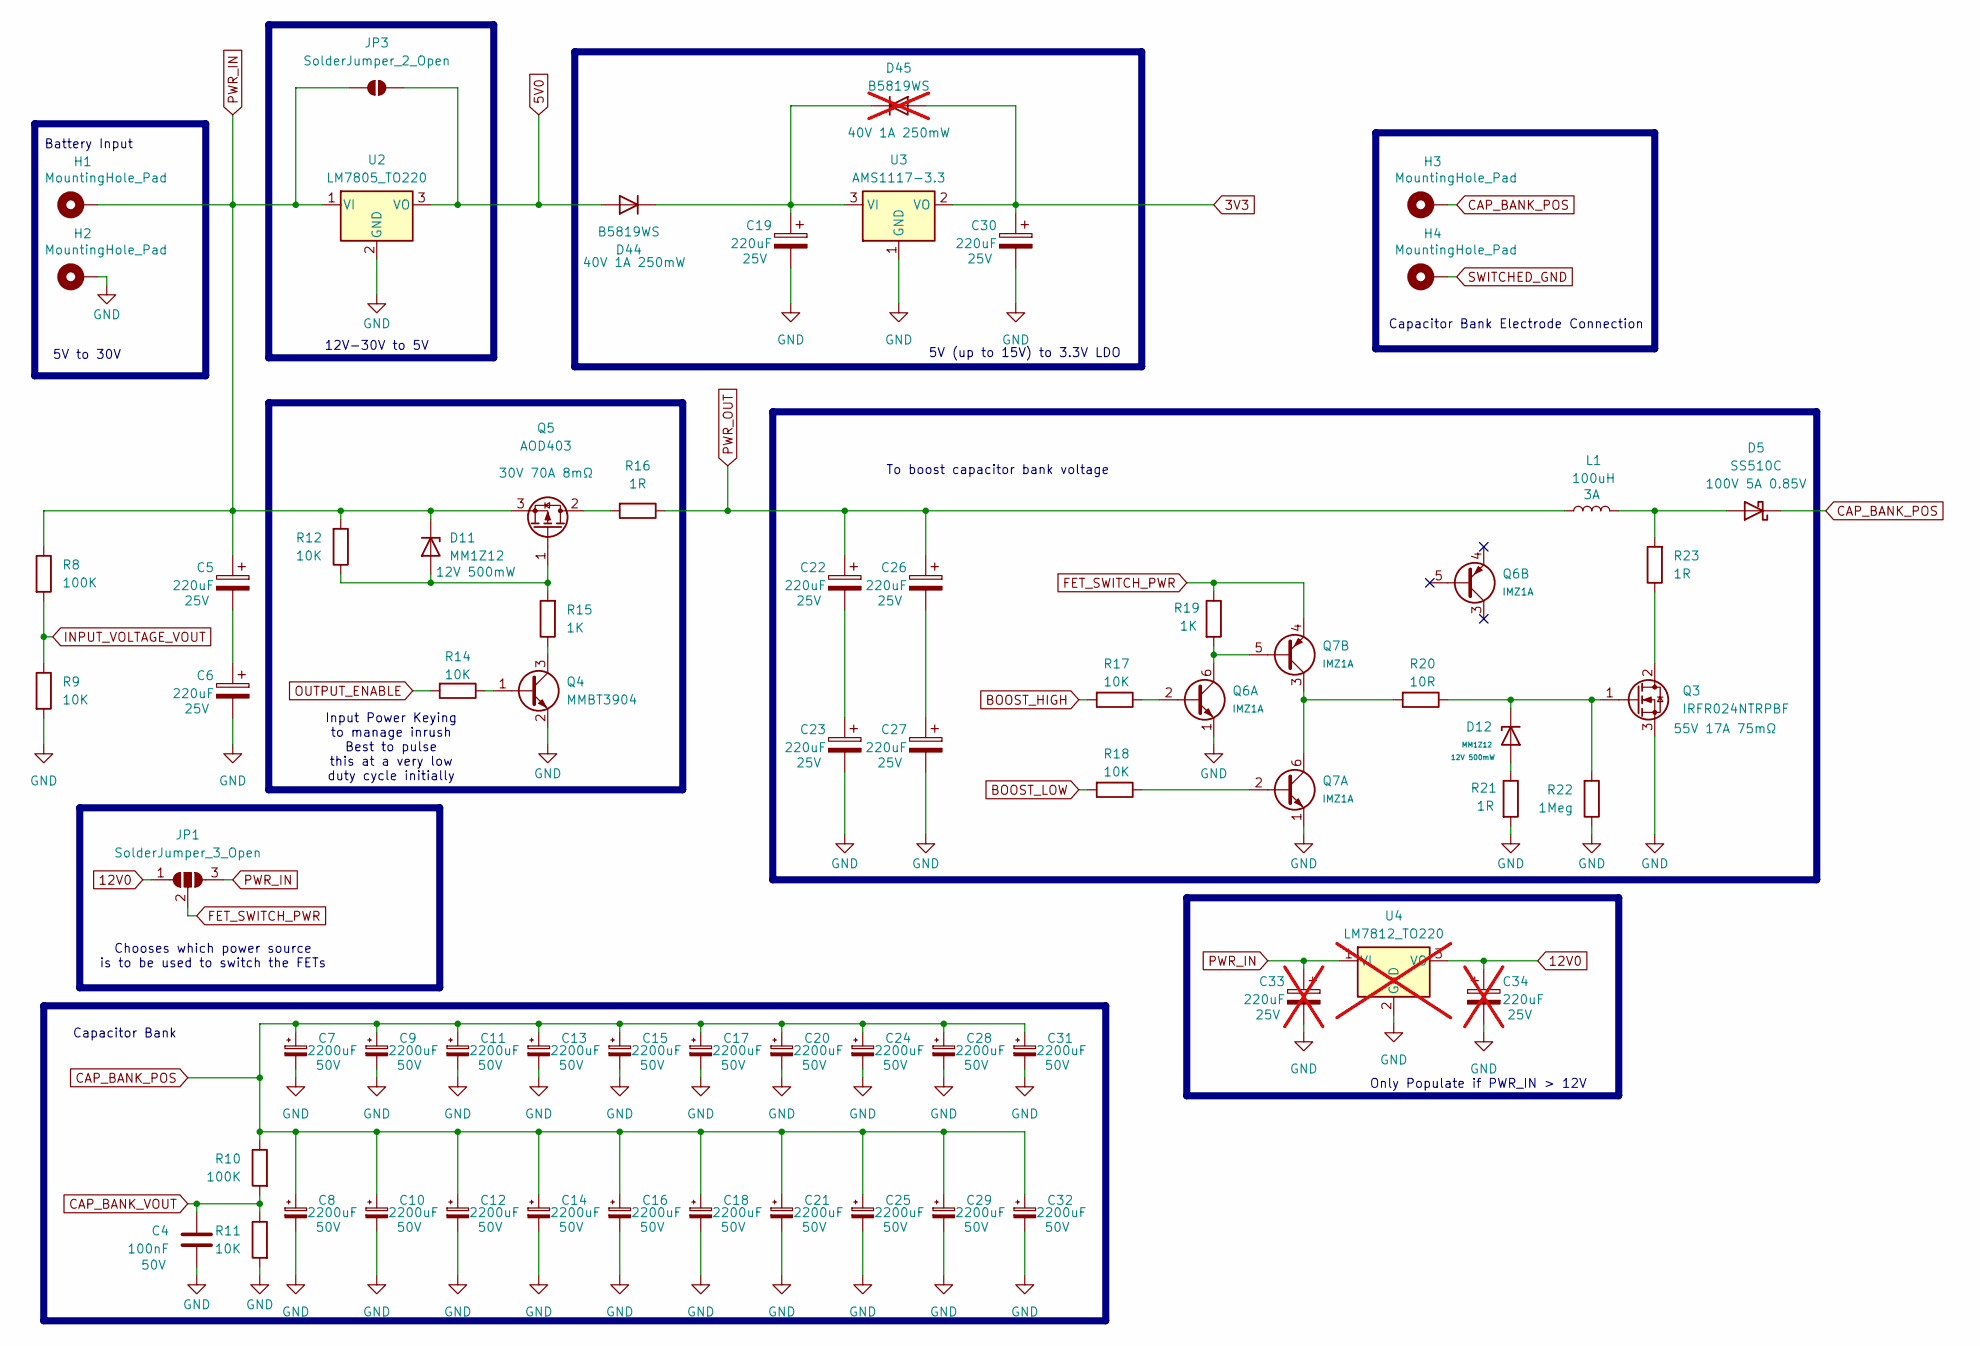
[picture p32: schematic power_input.kicad_sch, Power Input]

Parts:
C4: 100nF; C_0805_2012Metric; Rating 50V
C5, C6, C19, C22, C23, C26, C27, C30: 220uF; CP_Radial_D5.0mm_P2.00mm; Rating 25V
C7, C8, C9, C10, C11, C12, C13, C14, C15, C16, C17, C18, C20, C21, C24, C25, C28, C29, C31, C32: 2200uF; CP_Radial_D18.0mm_P7.50mm; Rating 50V
C33, C34: 220uF; CP_Radial_D5.0mm_P2.00mm; Rating 25V; not fitted
D5: SS510C; D_SMC; Rating 100V 5A 0.85V
D11, D12: MM1Z12; D_SOD-123; Rating 12V 500mW
D44: B5819WS; D_SOD-323; Rating 40V 1A 250mW
D45: B5819WS; D_SOD-323; Rating 40V 1A 250mW; not fitted
H1, H2, H3, H4: MountingHole_Pad; MountingHole_3.2mm_M3_Pad_Via
JP1: SolderJumper_3_Open; SolderJumper-3_P2.0mm_Open_TrianglePad1.0x1.5mm
JP3: SolderJumper_2_Open; SolderJumper-2_P1.3mm_Open_Pad1.0x1.5mm
L1: 100uH; L_Coilcraft_MSS1278H-XXX; Rating 3A
Q3: IRFR024NTRPBF; TO-252-2; Rating 55V 17A 75mΩ
Q4: MMBT3904; SOT-23
Q5: AOD403; TO-252-2; Rating 30V 70A 8mΩ
Q6, Q7: IMZ1A; SOT-23-6
R8, R10: 100K; R_0805_2012Metric
R9, R11, R12, R14, R17, R18: 10K; R_0805_2012Metric
R15, R19: 1K; R_0805_2012Metric
R16, R21, R23: 1R; R_0805_2012Metric
R20: 10R; R_0805_2012Metric
R22: 1Meg; R_0805_2012Metric
U2: LM7805_TO220; TO-220-3_Vertical
U3: AMS1117-3.3; SOT-223-3_TabPin2
U4: LM7812_TO220; TO-220-3_Vertical; not fitted

Connections:
3V3: C30.1, D45.2 (A), U3.2 (VO); also elsewhere on the board
5V0: D44.2 (A), JP3.2 (B), U2.3 (VO)
12V0: C34.1, JP1.1 (A), U4.3 (VO)
BOOST_HIGH: R17.2; also elsewhere on the board
BOOST_LOW: R18.2; also elsewhere on the board
CAP_BANK_POS: C7.1, C8.1, C9.1, C10.1, C11.1, C12.1, C13.1, C14.1, C15.1, C16.1, C17.1, C18.1, C20.1, C21.1, C24.1, C25.1, C28.1, C29.1, C31.1, C32.1, D5.1 (K), H3.1, R10.1
CAP_BANK_VOUT: C4.1, R10.2, R11.1; also elsewhere on the board
FET_SWITCH_PWR: JP1.2 (C), Q7.4 (E2), R19.1; also elsewhere on the board
GND: C4.2, C6.2, C7.2, C8.2, C9.2, C10.2, C11.2, C12.2, C13.2, C14.2, C15.2, C16.2, C17.2, C18.2, C19.2, C20.2, C21.2, C23.2, C24.2, C25.2, C27.2, C28.2, C29.2, C30.2, C31.2, C32.2, C33.2, C34.2, H2.1, Q3.3 (S), Q4.2 (E), Q6.1 (E1), Q7.1 (E1), R9.2, R11.2, R21.2, R22.1, U2.2 (GND), U3.1 (GND), U4.2 (GND); also elsewhere on the board
INPUT_VOLTAGE_VOUT: R8.2, R9.1; also elsewhere on the board
unnamed: C5.2, C6.1
unnamed: C22.2, C23.1
unnamed: C26.2, C27.1
unnamed: D5.2 (A), L1.2, R23.2
unnamed: D11.2 (A), Q5.1 (G), R12.1, R15.2
unnamed: D12.2 (A), R21.1
unnamed: D12.1 (K), Q3.1 (G), R20.1, R22.2
unnamed: C19.1, D44.1 (K), D45.1 (K), U3.3 (VI)
unnamed: Q3.2 (D), R23.1
unnamed: Q4.1 (B), R14.1
unnamed: Q4.3 (C), R15.1
unnamed: Q5.2 (D), R16.2
unnamed: Q6.2 (B1), R17.1
unnamed: Q6.6 (C1), Q7.5 (B2), R19.2
unnamed: Q7.2 (B1), R18.1
unnamed: Q7.3 (C2), Q7.6 (C1), R20.2
OUTPUT_ENABLE: R14.2
PWR_IN: C5.1, C33.1, D11.1 (K), H1.1, JP1.3 (B), JP3.1 (A), Q5.3 (S), R8.1, R12.2, U2.1 (VI), U4.1 (VI)
PWR_OUT: C22.1, C26.1, L1.1, R16.1
SWITCHED_GND: H4.1; also elsewhere on the board

Notes on the sheet:
Only Populate if PWR_IN > 12V
5V (up to 15V) to 3.3V LDO
To boost capacitor bank voltage
Battery Input
12V-30V to 5V
Capacitor Bank
Input Power Keying to manage inrush Best to pulse this at a very low duty cycle initially
Chooses which power source is to be used to switch the FETs
Capacitor Bank Electrode Connection
5V to 30V

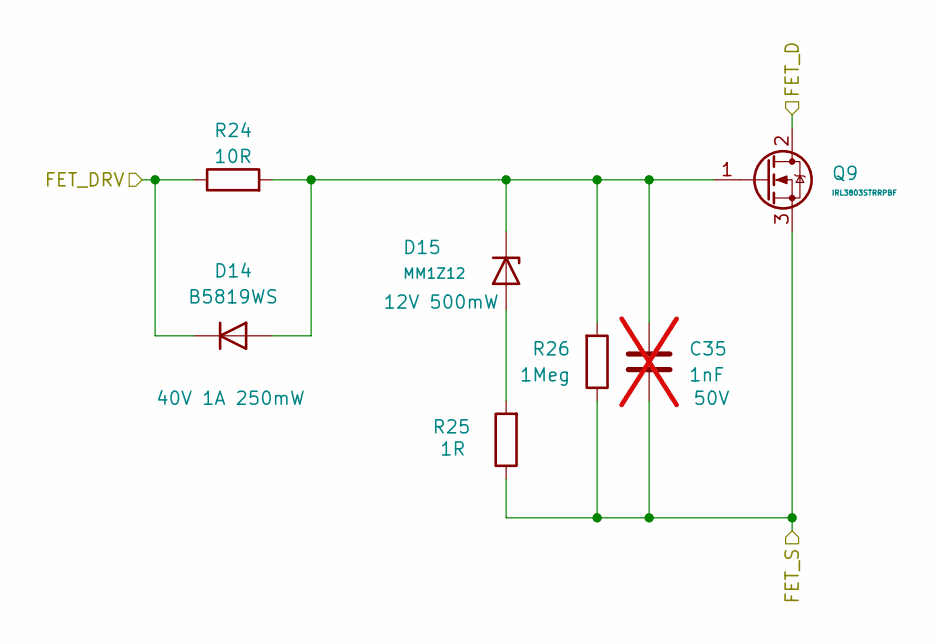
[picture p33: schematic main_fet.kicad_sch]

Parts:
C35: 1nF; C_0805_2012Metric; Rating 50V; not fitted
D14: B5819WS; D_SOD-323; Rating 40V 1A 250mW
D15: MM1Z12; D_SOD-123; Rating 12V 500mW
Q9: IRL3803STRRPBF; TO-263-2
R24: 10R; R_0805_2012Metric
R25: 1R; R_0805_2012Metric
R26: 1Meg; R_0805_2012Metric

Connections:
FET_DRIVE: D14.1 (K), R24.1; also elsewhere on the board
GND: C35.2, Q9.3 (S), R25.1, R26.1; also elsewhere on the board
unnamed: C35.1, D14.2 (A), D15.1 (K), Q9.1 (G), R24.2, R26.2
unnamed: D15.2 (A), R25.2
SWITCHED_GND: Q9.2 (D); also elsewhere on the board

Parts of its further copies:
C36, C37, C38, C39, C40, C41, C42, C43, C44, C45, C46: 1nF; C_0805_2012Metric; Rating 50V; not fitted
D16, D18, D20, D22, D24, D26, D28, D30, D32, D34, D36: B5819WS; D_SOD-323; Rating 40V 1A 250mW
D17, D19, D21, D23, D25, D27, D29, D31, D33, D35, D37: MM1Z12; D_SOD-123; Rating 12V 500mW
Q10, Q11, Q12, Q13, Q14, Q15, Q16, Q17, Q18, Q19, Q20: IRL3803STRRPBF; TO-263-2
R27, R30, R33, R36, R39, R42, R45, R48, R51, R54, R57: 10R; R_0805_2012Metric
R28, R31, R34, R37, R40, R43, R46, R49, R52, R55, R58: 1R; R_0805_2012Metric
R29, R32, R35, R38, R41, R44, R47, R50, R53, R56, R59: 1Meg; R_0805_2012Metric

Connections of its further copies:
FET_DRIVE: D16.1 (K), D18.1 (K), D20.1 (K), D22.1 (K), D24.1 (K), D26.1 (K), D28.1 (K), D30.1 (K), D32.1 (K), D34.1 (K), D36.1 (K), R27.1, R30.1, R33.1, R36.1, R39.1, R42.1, R45.1, R48.1, R51.1, R54.1, R57.1; also elsewhere on the board
GND: C36.2, C37.2, C38.2, C39.2, C40.2, C41.2, C42.2, C43.2, C44.2, C45.2, C46.2, Q10.3 (S), Q11.3 (S), Q12.3 (S), Q13.3 (S), Q14.3 (S), Q15.3 (S), Q16.3 (S), Q17.3 (S), Q18.3 (S), Q19.3 (S), Q20.3 (S), R28.1, R29.1, R31.1, R32.1, R34.1, R35.1, R37.1, R38.1, R40.1, R41.1, R43.1, R44.1, R46.1, R47.1, R49.1, R50.1, R52.1, R53.1, R55.1, R56.1, R58.1, R59.1; also elsewhere on the board
unnamed: C36.1, D16.2 (A), D17.1 (K), Q10.1 (G), R27.2, R29.2
unnamed: D17.2 (A), R28.2
unnamed: C37.1, D18.2 (A), D19.1 (K), Q11.1 (G), R30.2, R32.2
unnamed: D19.2 (A), R31.2
unnamed: C38.1, D20.2 (A), D21.1 (K), Q12.1 (G), R33.2, R35.2
unnamed: D21.2 (A), R34.2
unnamed: C39.1, D22.2 (A), D23.1 (K), Q13.1 (G), R36.2, R38.2
unnamed: D23.2 (A), R37.2
unnamed: C40.1, D24.2 (A), D25.1 (K), Q14.1 (G), R39.2, R41.2
unnamed: D25.2 (A), R40.2
unnamed: C41.1, D26.2 (A), D27.1 (K), Q15.1 (G), R42.2, R44.2
unnamed: D27.2 (A), R43.2
unnamed: C42.1, D28.2 (A), D29.1 (K), Q16.1 (G), R45.2, R47.2
unnamed: D29.2 (A), R46.2
unnamed: C43.1, D30.2 (A), D31.1 (K), Q17.1 (G), R48.2, R50.2
unnamed: D31.2 (A), R49.2
unnamed: C44.1, D32.2 (A), D33.1 (K), Q18.1 (G), R51.2, R53.2
unnamed: D33.2 (A), R52.2
unnamed: C45.1, D34.2 (A), D35.1 (K), Q19.1 (G), R54.2, R56.2
unnamed: D35.2 (A), R55.2
unnamed: C46.1, D36.2 (A), D37.1 (K), Q20.1 (G), R57.2, R59.2
unnamed: D37.2 (A), R58.2
SWITCHED_GND: Q10.2 (D), Q11.2 (D), Q12.2 (D), Q13.2 (D), Q14.2 (D), Q15.2 (D), Q16.2 (D), Q17.2 (D), Q18.2 (D), Q19.2 (D), Q20.2 (D); also elsewhere on the board

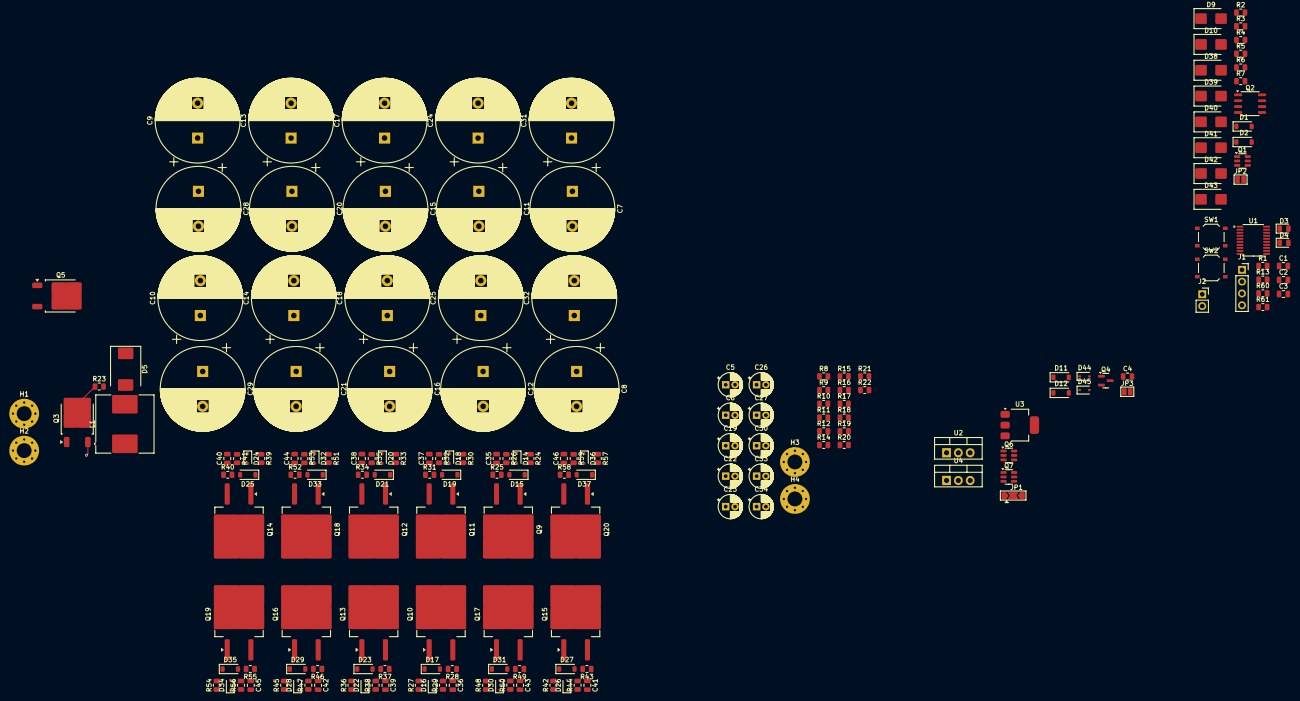
[picture p34: board SimpleSpotWelder.kicad_pcb from above]

Board: 2 copper layers, 183 parts (0 on the bottom side), 70 nets.
