ShrinathN/SimpleSpotWelder/SimpleSpotWelder_Firmware/SimpleSpotWelder_Firmware.ioc

Mcu.UserName=STM32G030F6Px
PA0.Signal=ADC1_IN0
PA1.Signal=ADC1_IN1
PA13.Signal=SYS_SWDIO
PA14-BOOT0.Signal=SYS_SWCLK
